craigyjp/PolyKit-DUO-polyphonic-synthesizer/block_diagram.jpg

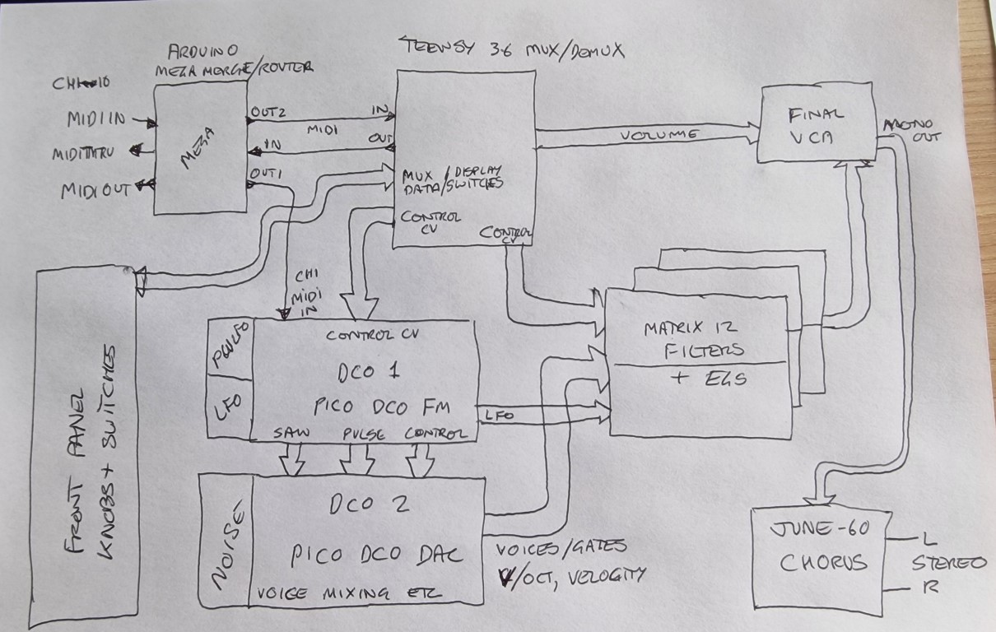
block_diagram.jpg
