craigyjp/PolyKit-DUO-polyphonic-synthesizer/photos/20220804_140941 (Medium).jpg

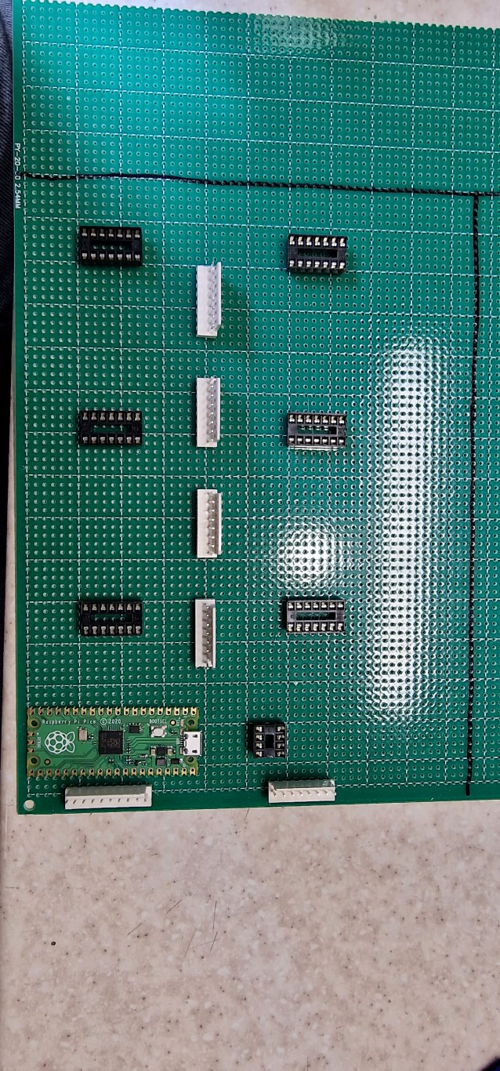
photos/20220804_140941 (Medium).jpg
