craigyjp/PolyKit-DUO-polyphonic-synthesizer/photos/20220806_120722 (Medium).jpg

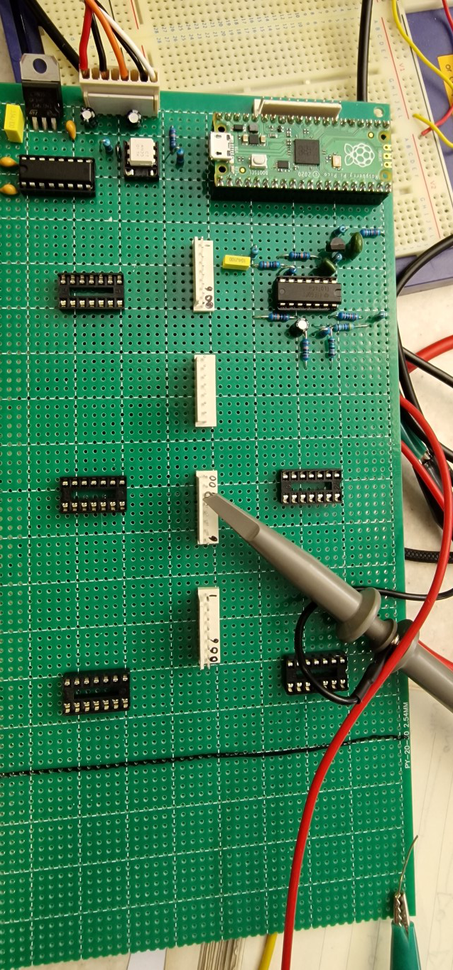
photos/20220806_120722 (Medium).jpg
