craigyjp/PolyKit-DUO-polyphonic-synthesizer/photos/20220806_134830 (Medium).jpg

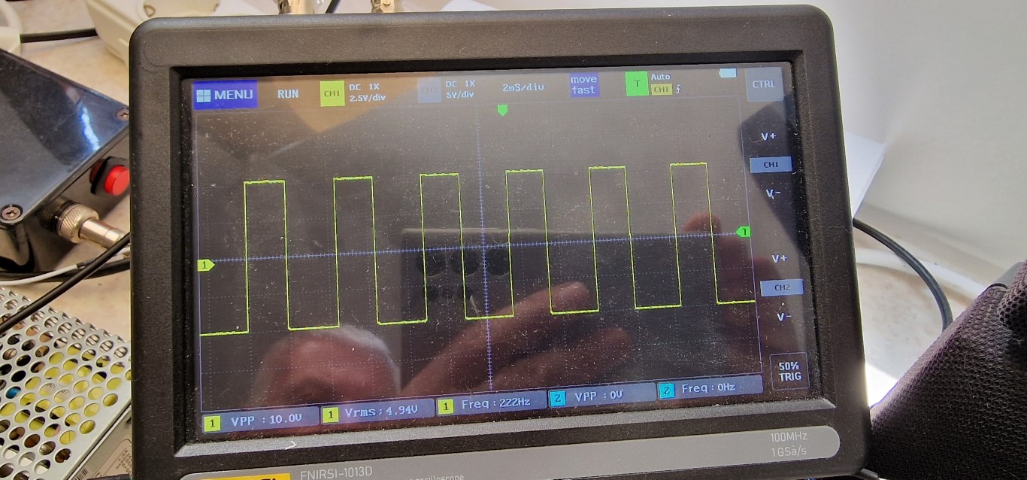
photos/20220806_134830 (Medium).jpg
