craigyjp/PolyKit-DUO-polyphonic-synthesizer/photos/20220806_134958 (Medium).jpg

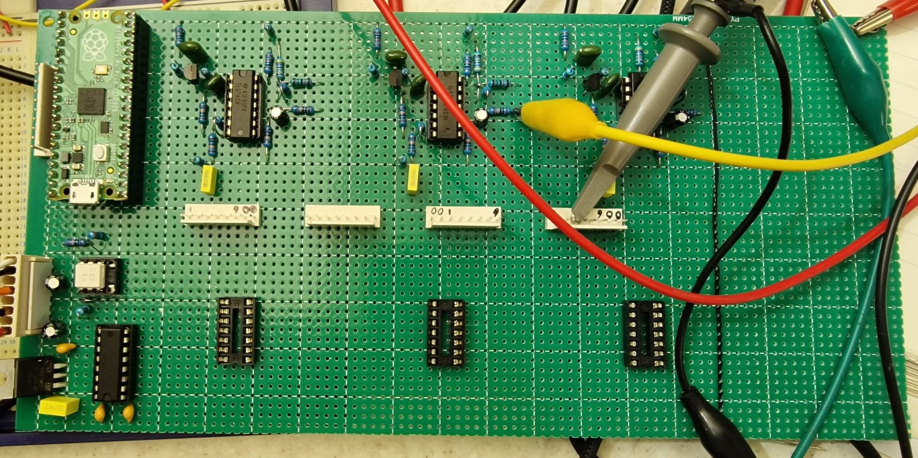
photos/20220806_134958 (Medium).jpg
