craigyjp/PolyKit-DUO-polyphonic-synthesizer/photos/20220814_142116 (Medium).jpg

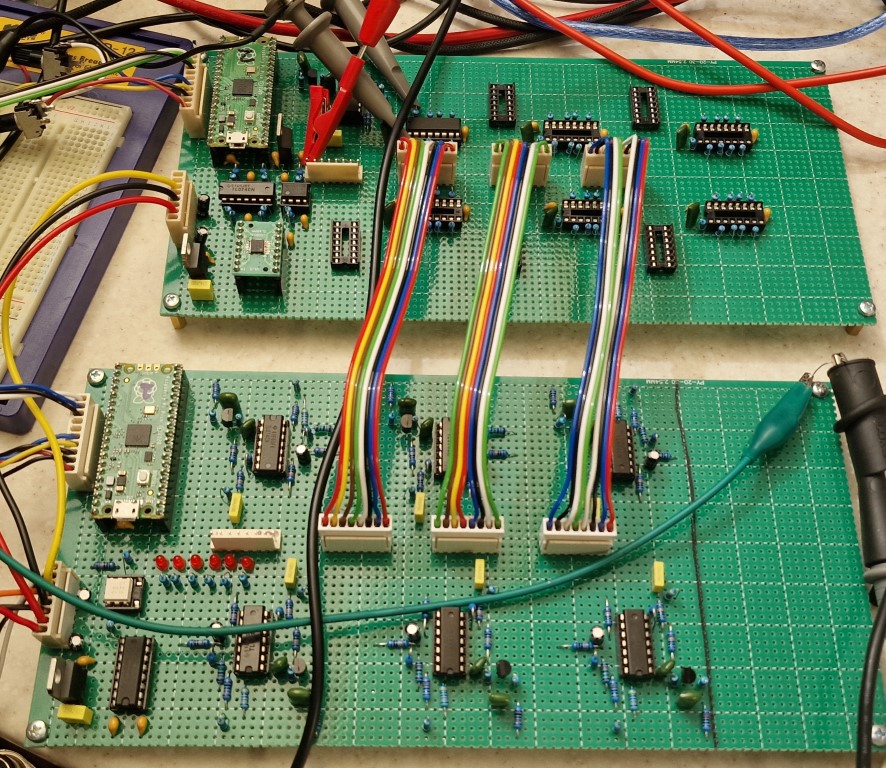
photos/20220814_142116 (Medium).jpg
