craigyjp/PolyKit-DUO-polyphonic-synthesizer/photos/20220903_174634 (Medium).jpg

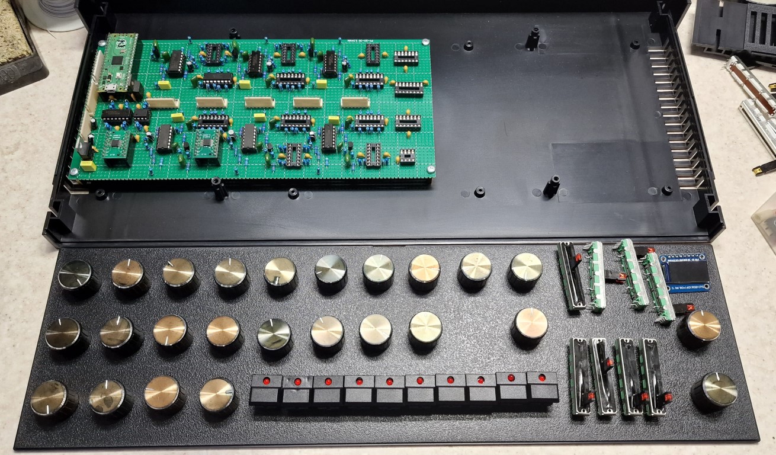
photos/20220903_174634 (Medium).jpg
