craigyjp/PolyKit-DUO-polyphonic-synthesizer/photos/20220903_183336 (Medium).jpg

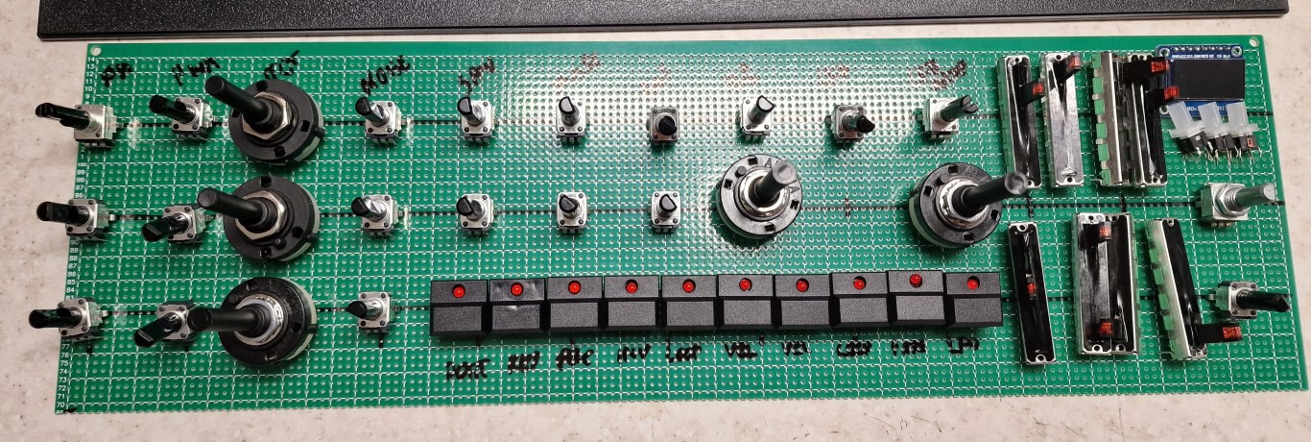
photos/20220903_183336 (Medium).jpg
