craigyjp/PolyKit-DUO-polyphonic-synthesizer/photos/20220903_201736 (Medium).jpg

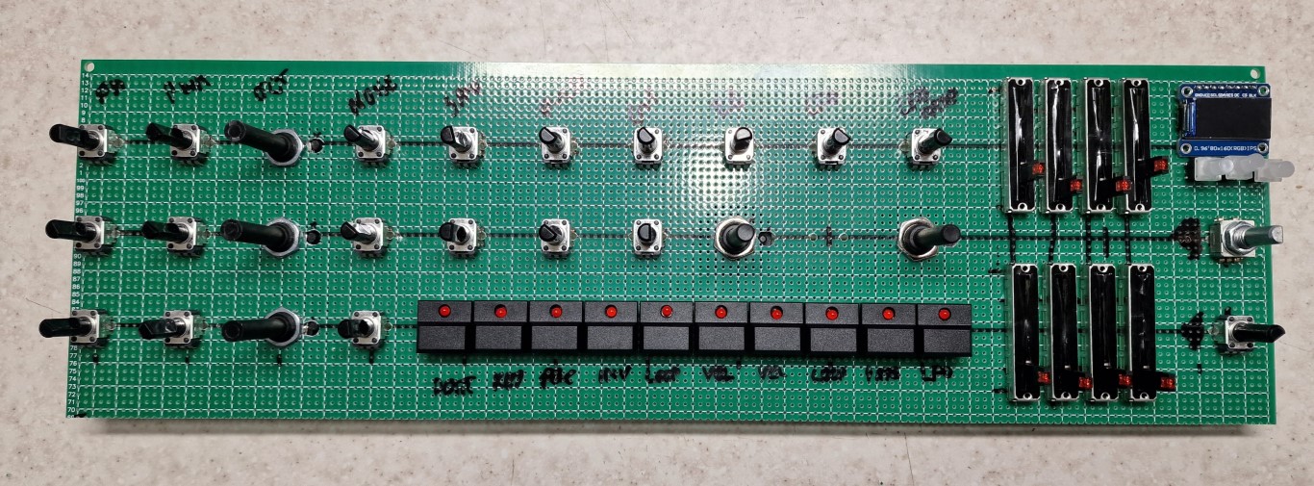
photos/20220903_201736 (Medium).jpg
