craigyjp/PolyKit-DUO-polyphonic-synthesizer/photos/20220903_202641 (Medium).jpg

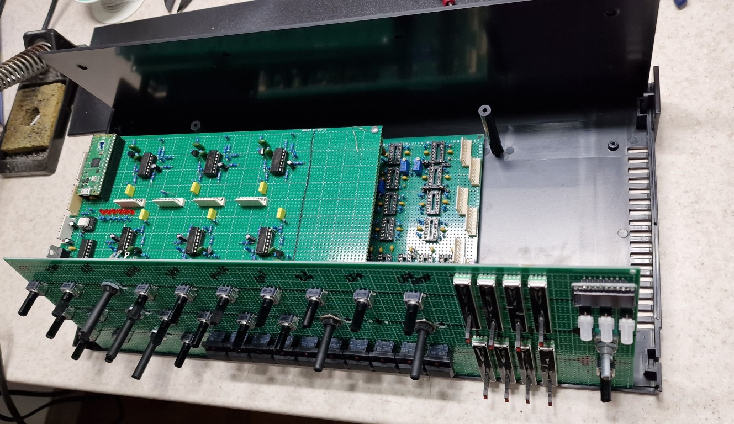
photos/20220903_202641 (Medium).jpg
