craigyjp/PolyKit-DUO-polyphonic-synthesizer/photos/20220904_141923 (Medium).jpg

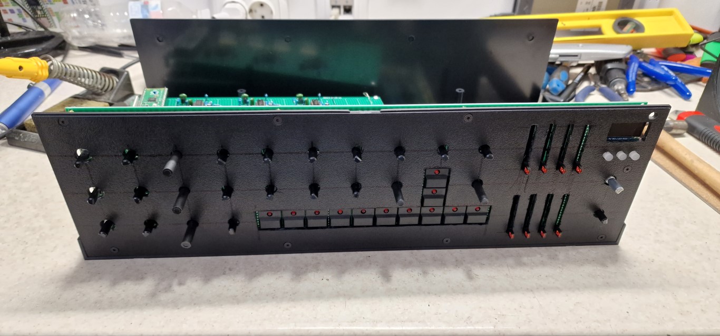
photos/20220904_141923 (Medium).jpg
