craigyjp/PolyKit-DUO-polyphonic-synthesizer/photos/20220904_142112 (Medium).jpg

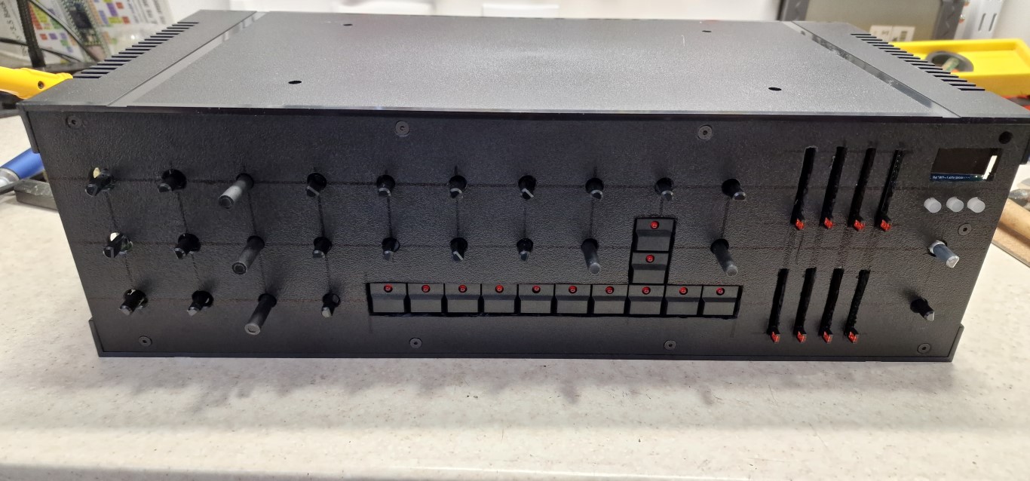
photos/20220904_142112 (Medium).jpg
