craigyjp/PolyKit-DUO-polyphonic-synthesizer/photos/20220905_204254 (Medium).jpg

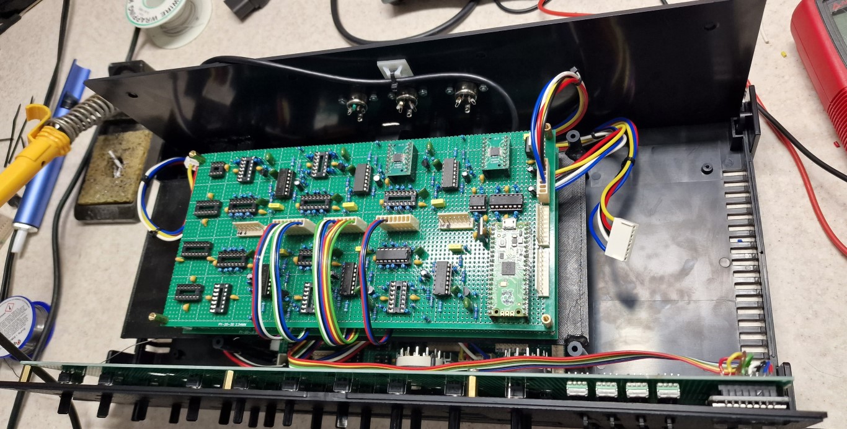
photos/20220905_204254 (Medium).jpg
