craigyjp/PolyKit-DUO-polyphonic-synthesizer/photos/20220906_171613 (Medium).jpg

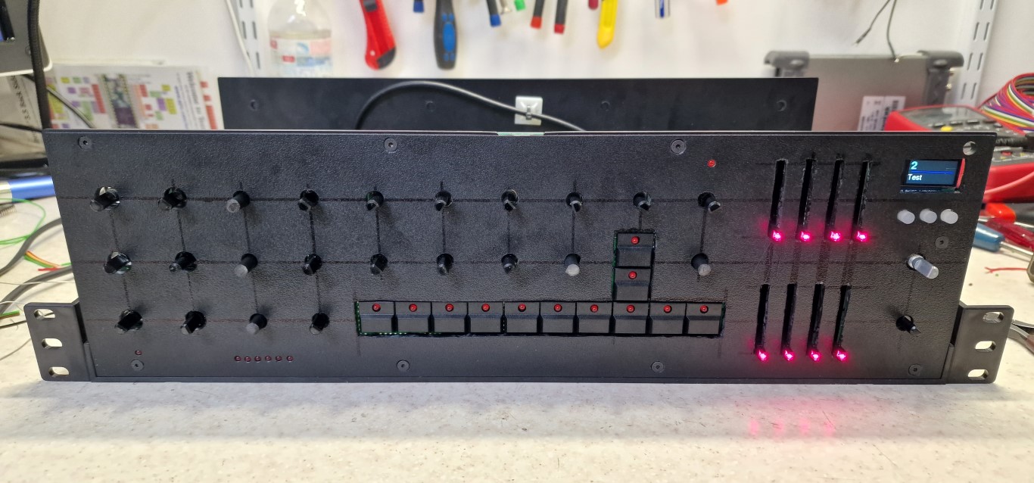
photos/20220906_171613 (Medium).jpg
