craigyjp/PolyKit-DUO-polyphonic-synthesizer/photos/20220906_172613 (Medium).jpg

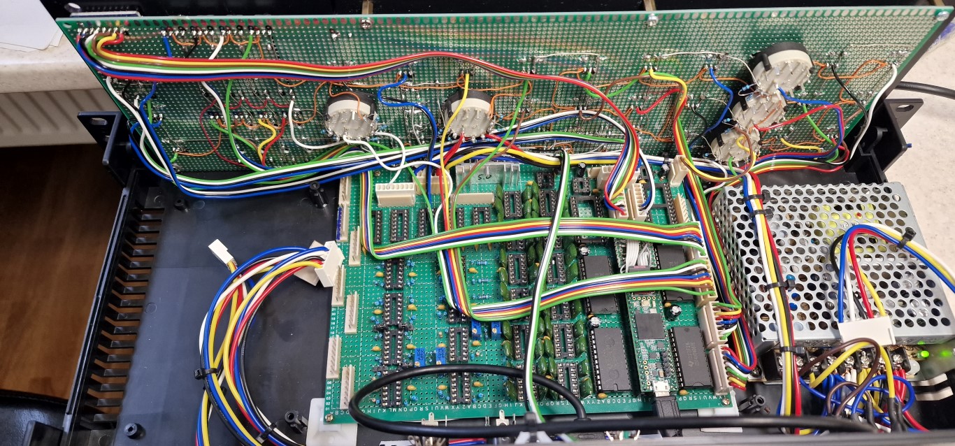
photos/20220906_172613 (Medium).jpg
