craigyjp/PolyKit-DUO-polyphonic-synthesizer/photos/20220908_191327 (Medium).jpg

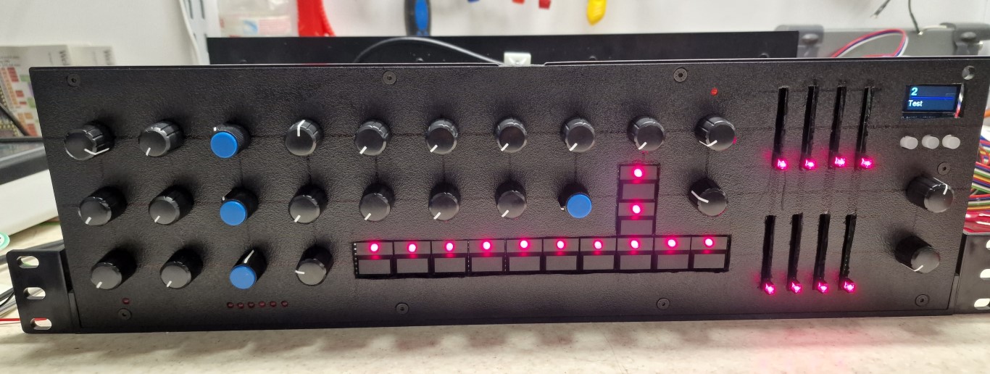
photos/20220908_191327 (Medium).jpg
