craigyjp/PolyKit-DUO-polyphonic-synthesizer/photos/20220908_191333 (Medium).jpg

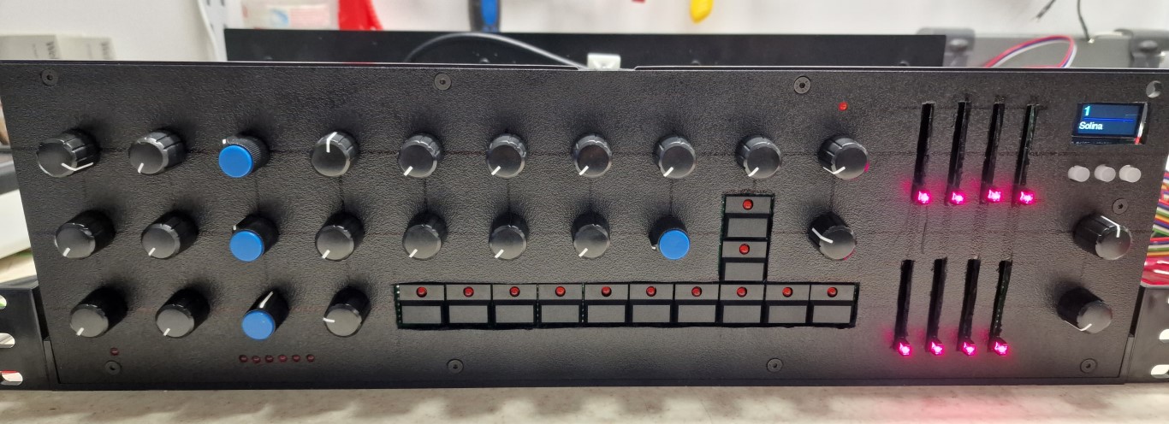
photos/20220908_191333 (Medium).jpg
