craigyjp/PolyKit-DUO-polyphonic-synthesizer/photos/20220909_180552 (Medium).jpg

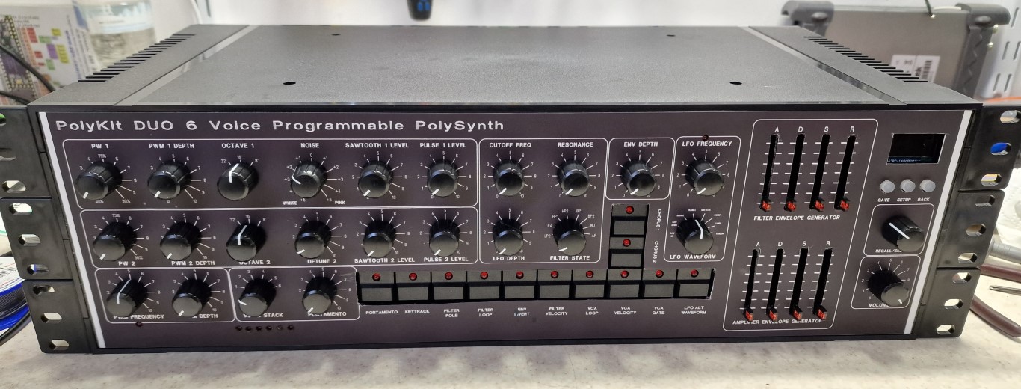
photos/20220909_180552 (Medium).jpg
