craigyjp/PolyKit-DUO-polyphonic-synthesizer/photos/20220909_211127 (Medium).jpg

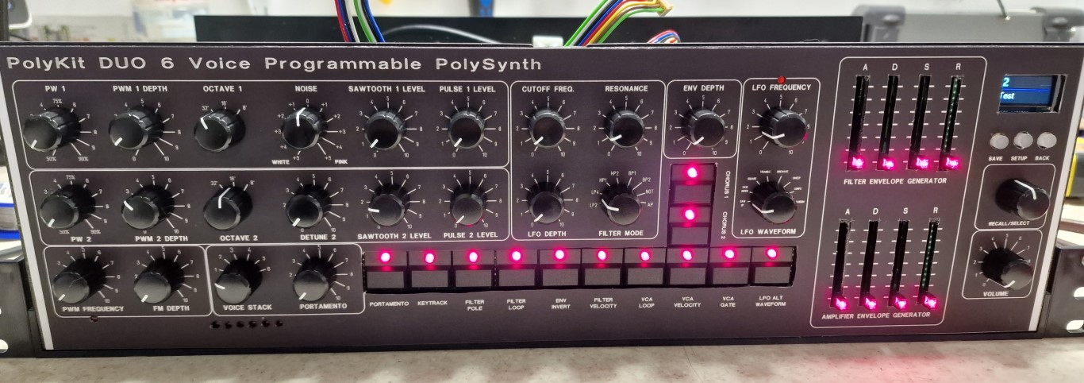
photos/20220909_211127 (Medium).jpg
