craigyjp/PolyKit-DUO-polyphonic-synthesizer/photos/20220912_173930 (Medium).jpg

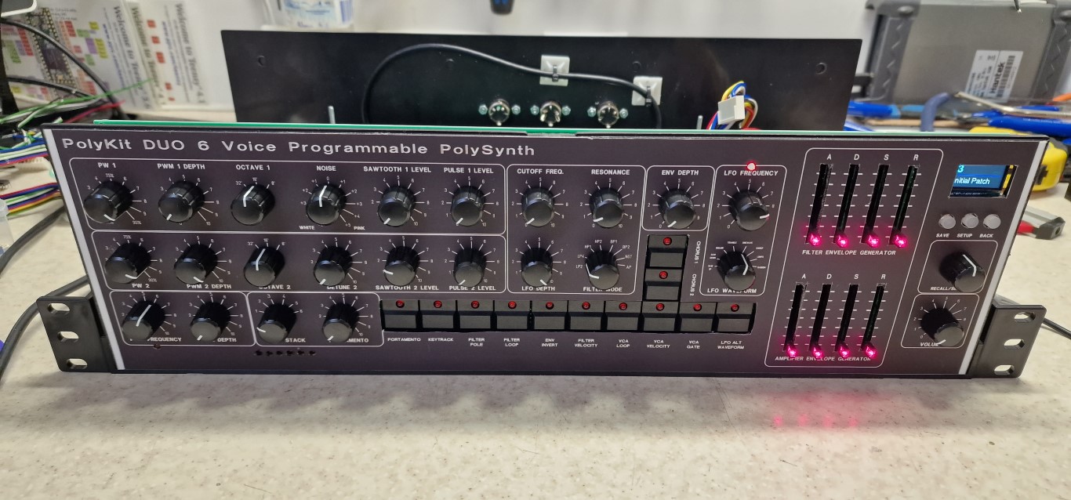
photos/20220912_173930 (Medium).jpg
