craigyjp/PolyKit-DUO-polyphonic-synthesizer/photos/20220913_212919 (Medium).jpg

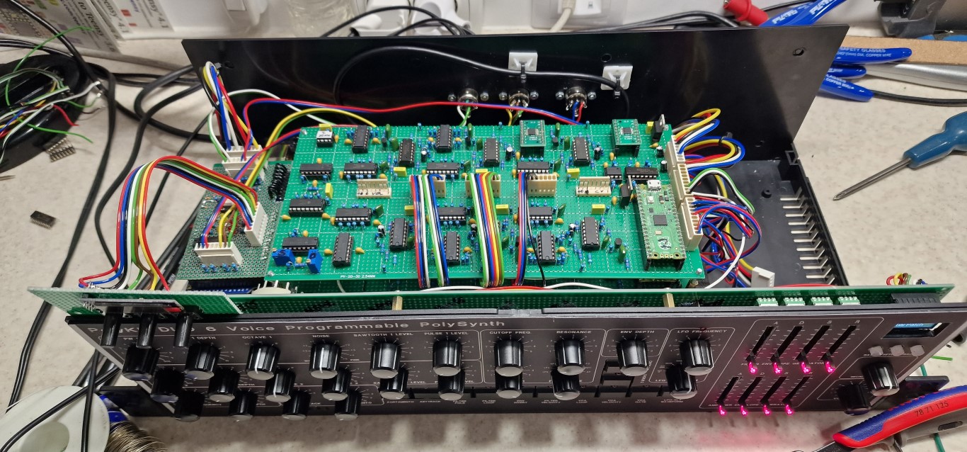
photos/20220913_212919 (Medium).jpg
