craigyjp/PolyKit-DUO-polyphonic-synthesizer/photos/20220913_213019 (Medium).jpg

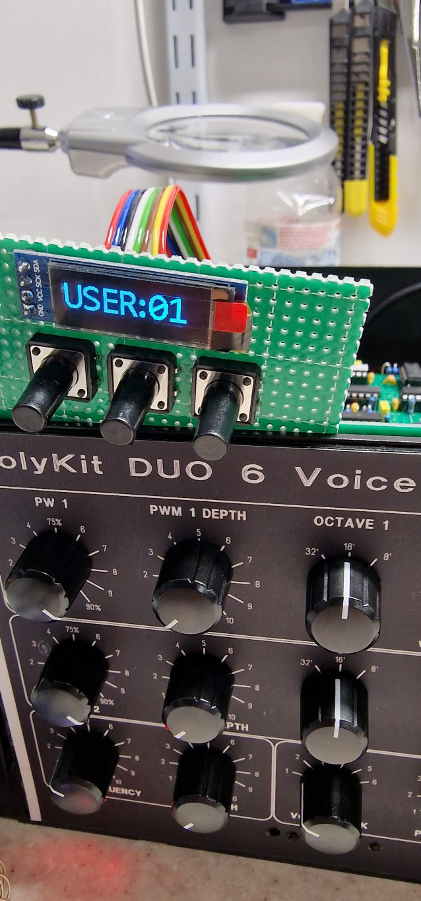
photos/20220913_213019 (Medium).jpg
