craigyjp/PolyKit-DUO-polyphonic-synthesizer/photos/20220914_204759 (Medium).jpg

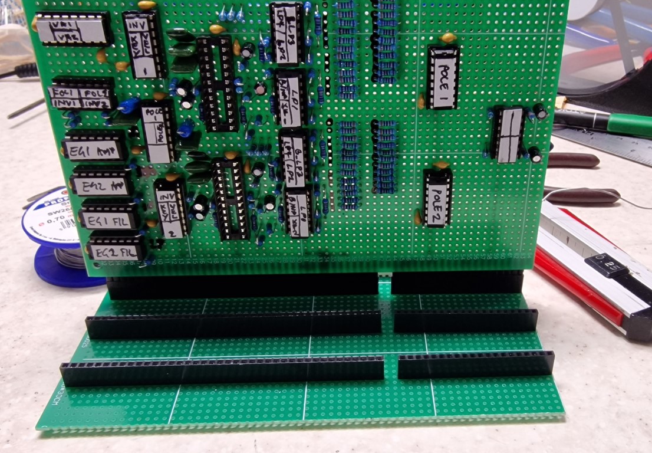
photos/20220914_204759 (Medium).jpg
