craigyjp/PolyKit-DUO-polyphonic-synthesizer/photos/20220914_204813 (Medium).jpg

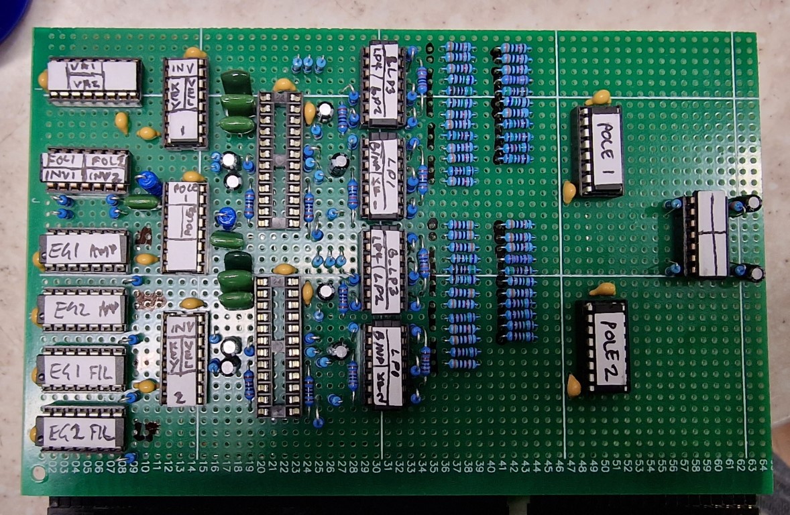
photos/20220914_204813 (Medium).jpg
