craigyjp/PolyKit-DUO-polyphonic-synthesizer/photos/20220915_210134 (Medium).jpg

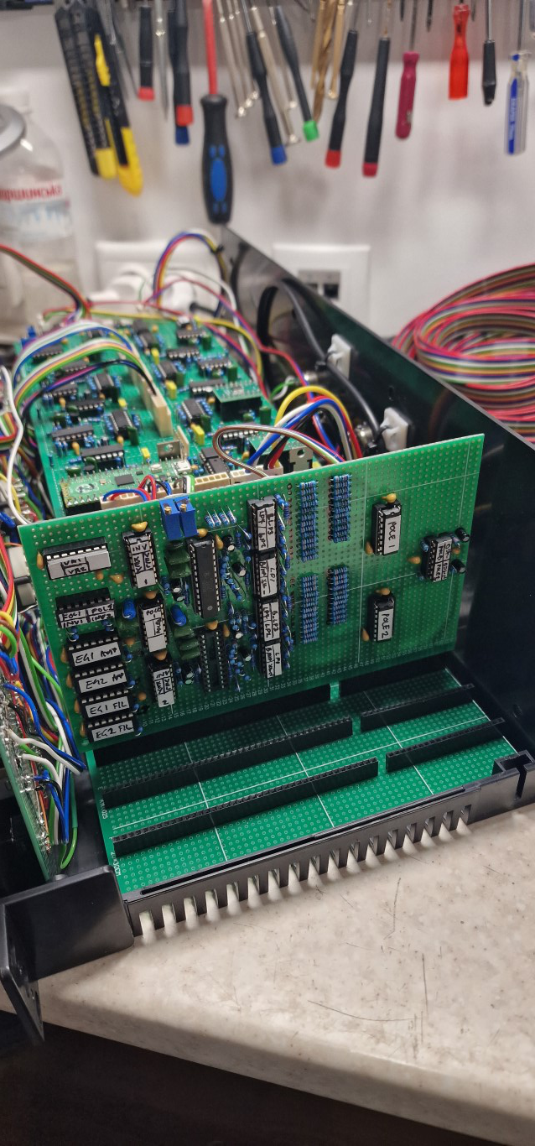
photos/20220915_210134 (Medium).jpg
