craigyjp/PolyKit-DUO-polyphonic-synthesizer/photos/20220918_163507 (Medium).jpg

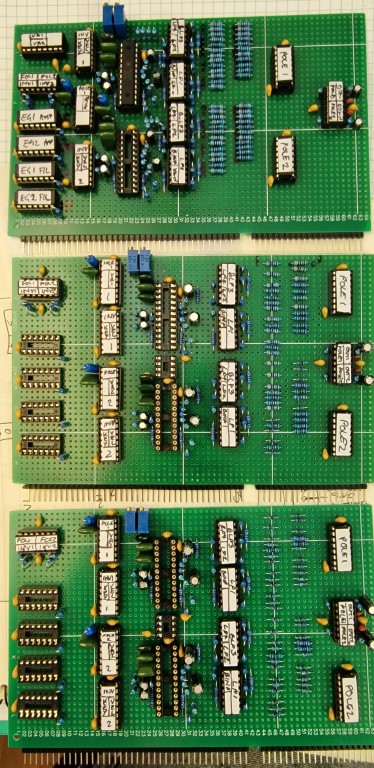
photos/20220918_163507 (Medium).jpg
