craigyjp/PolyKit-DUO-polyphonic-synthesizer/photos/20220919_204006 (Medium).jpg

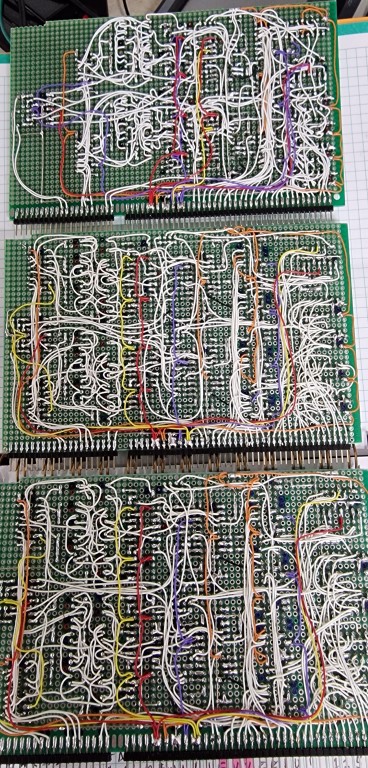
photos/20220919_204006 (Medium).jpg
