craigyjp/PolyKit-DUO-polyphonic-synthesizer/photos/20220921_220232 (Medium).jpg

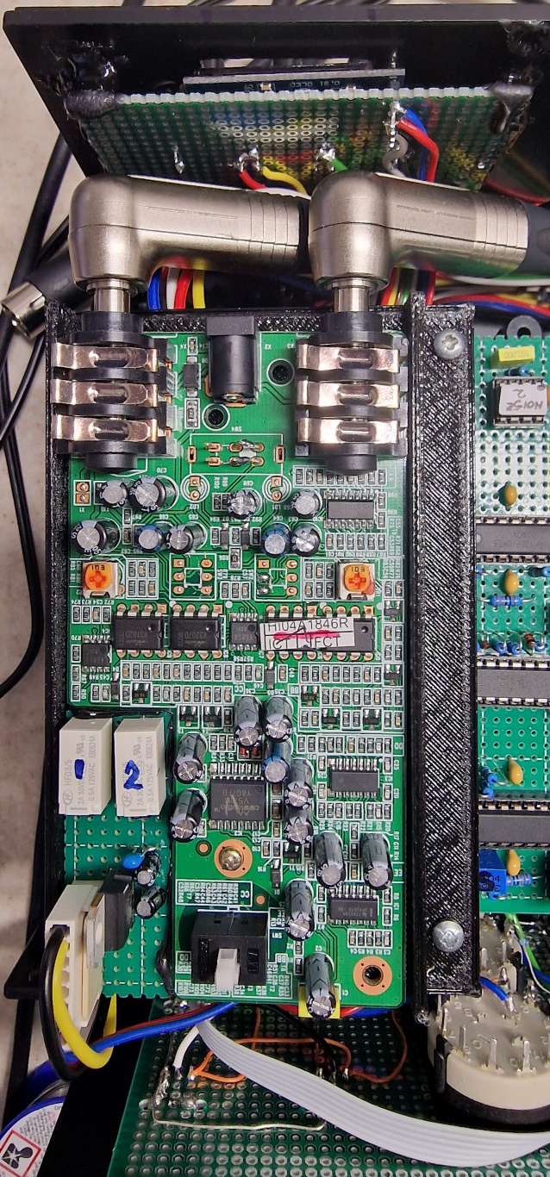
photos/20220921_220232 (Medium).jpg
