craigyjp/PolyKit-DUO-polyphonic-synthesizer/photos/FB_IMG_1662670874950 (Medium).jpg

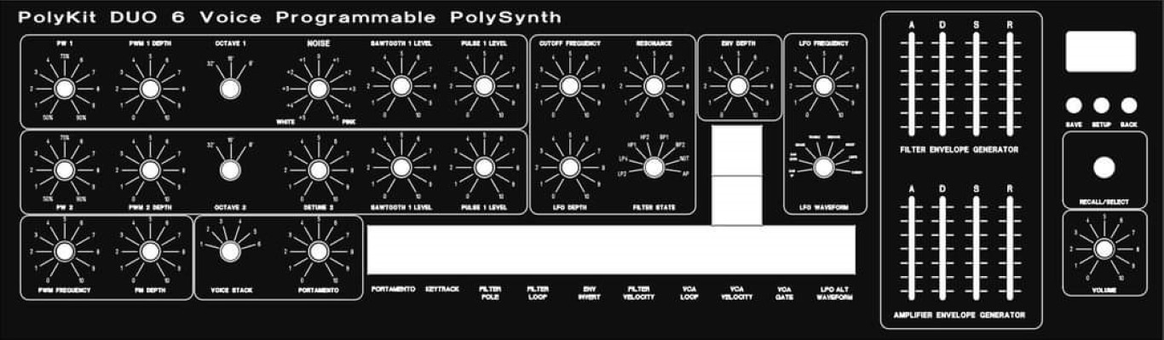
photos/FB_IMG_1662670874950 (Medium).jpg
