craigyjp/PolyKit-DUO-polyphonic-synthesizer/photos/received_1017338315625798 (Medium).jpg

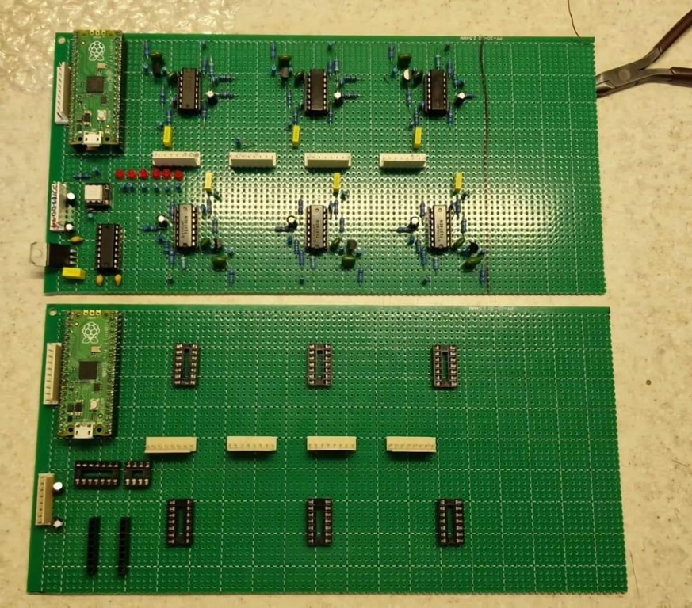
photos/received_1017338315625798 (Medium).jpg
