craigyjp/PolyKit-DUO-polyphonic-synthesizer/schematics/Schematic_Noise Fader_2022-01-20.pdf

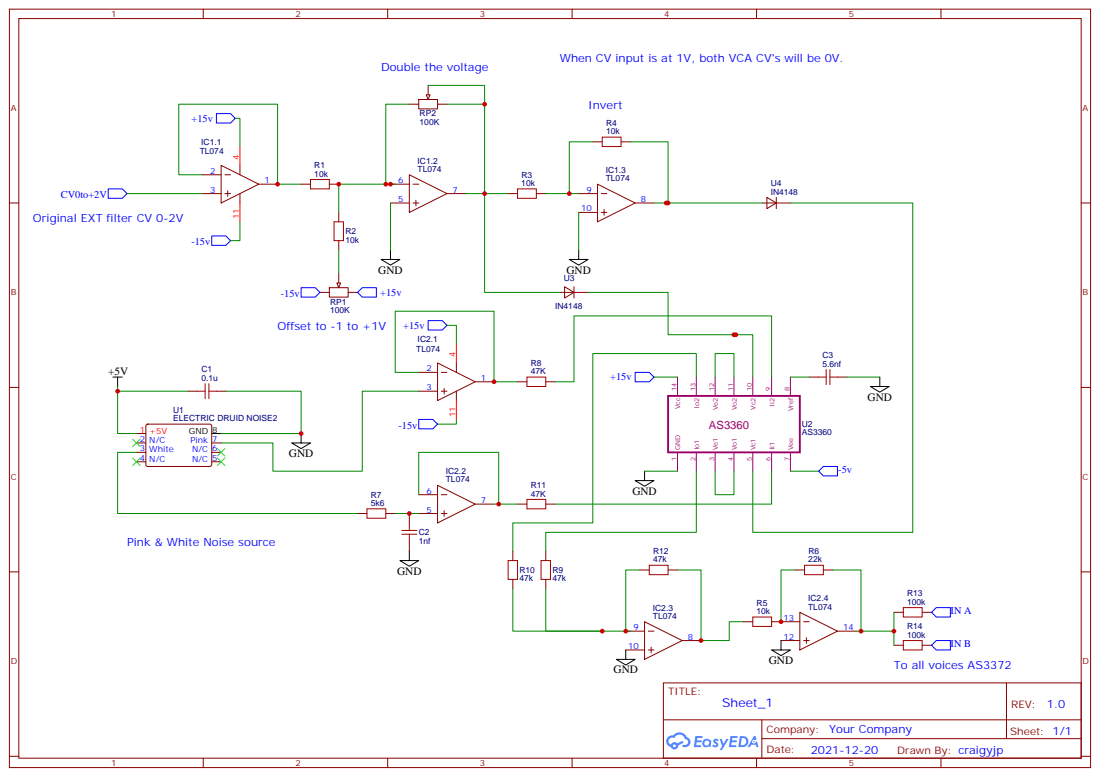
[picture p35: page 1]

When CV input is at 1V, both VCA CV's will be 0V.

Original EXT filter CV 0-2V

Pink & White Noise source
