craigyjp/PolyKit-DUO-polyphonic-synthesizer/schematics/programmer1.pdf

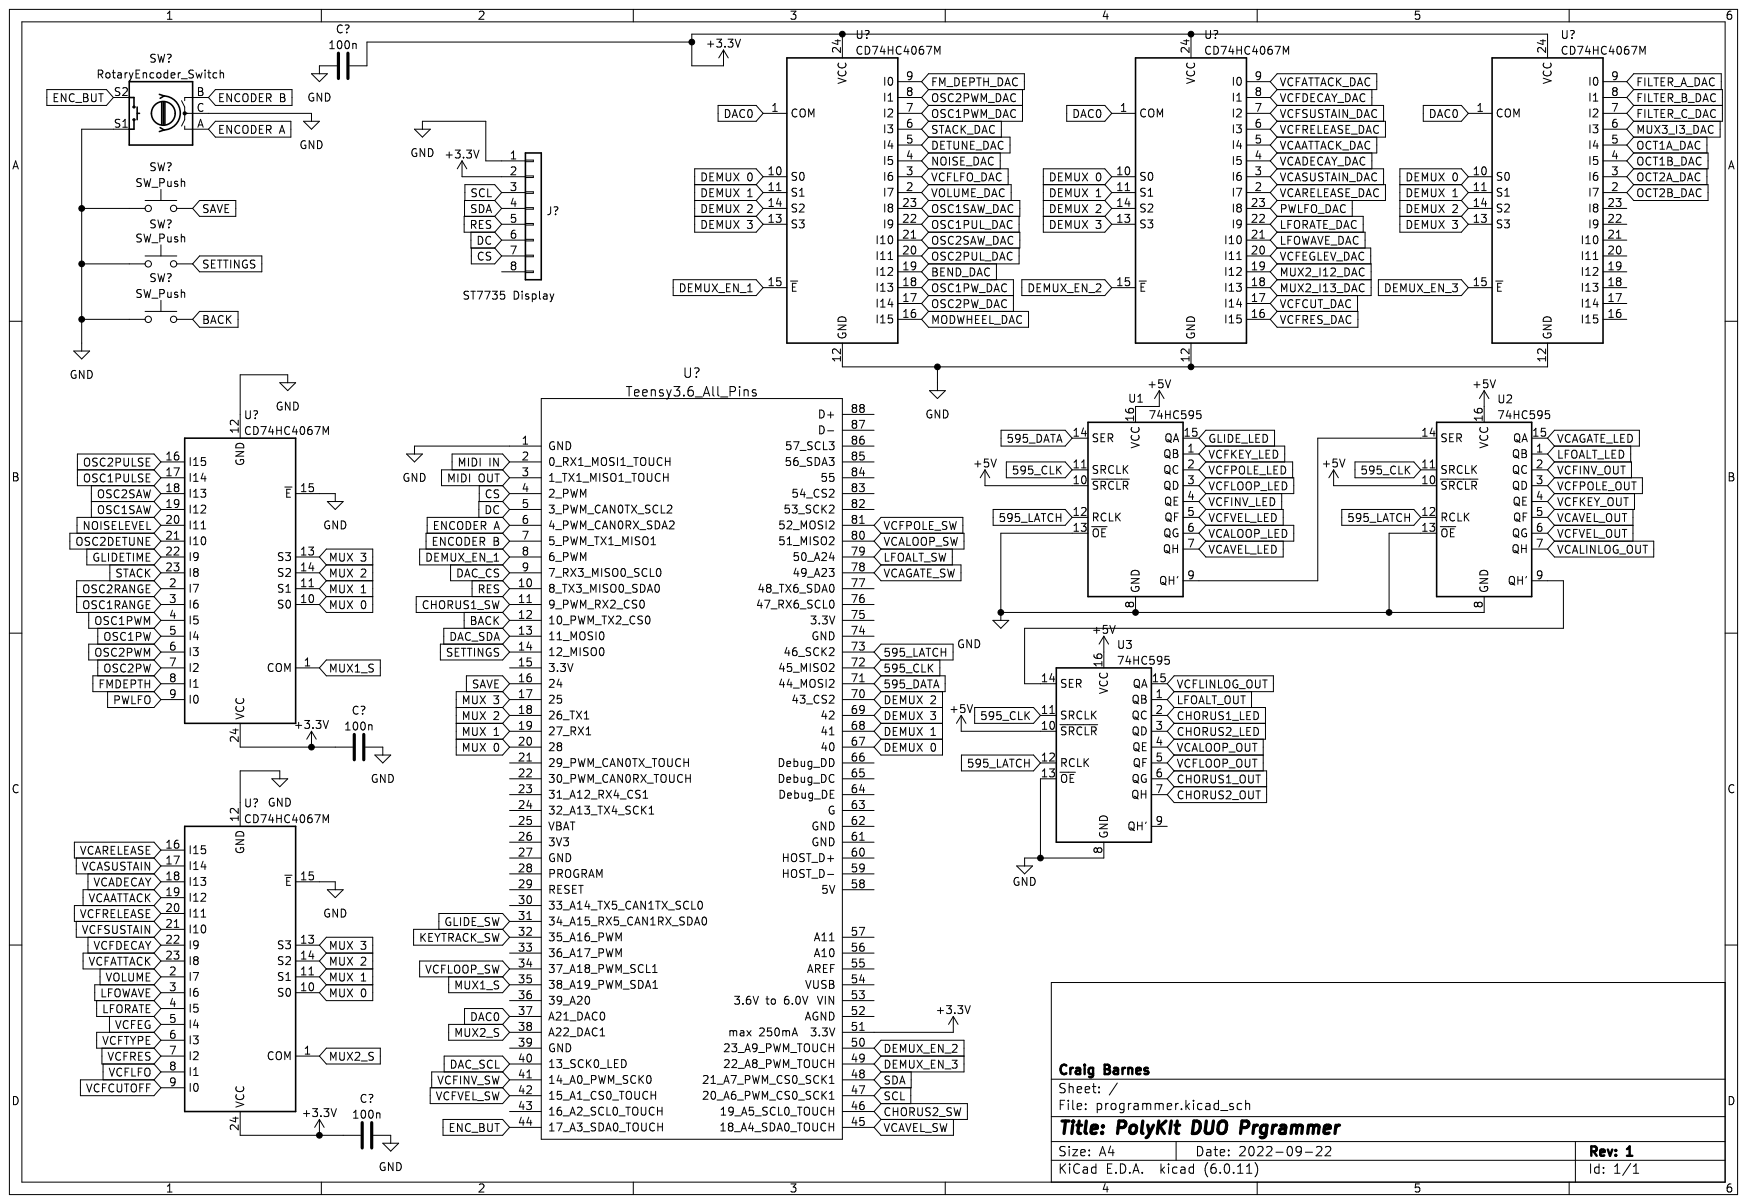
[picture p36: page 1]
