craigyjp/PolyKit-DUO-polyphonic-synthesizer/schematics/DCO-analogue.pdf

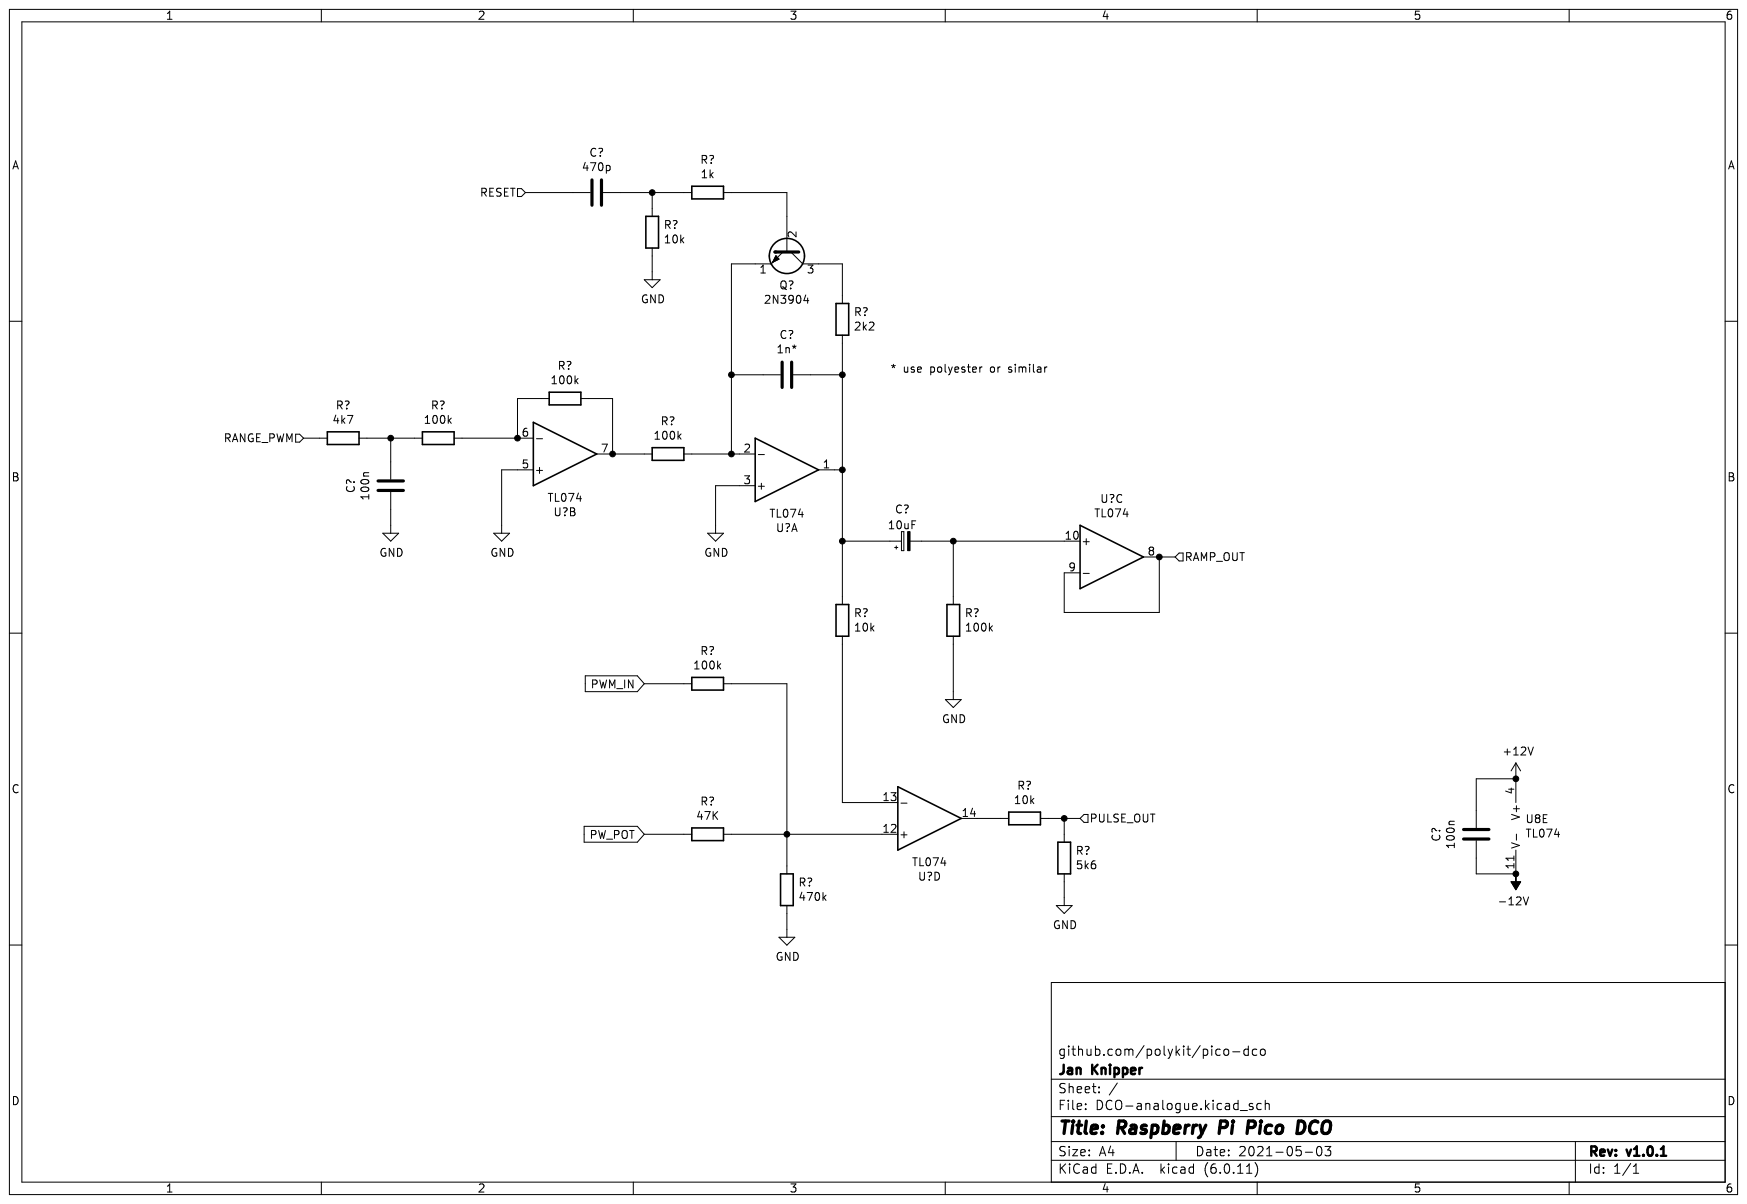
[picture p37: page 1]
