craigyjp/PolyKit-DUO-polyphonic-synthesizer/schematics/pico-dco-fm.pdf

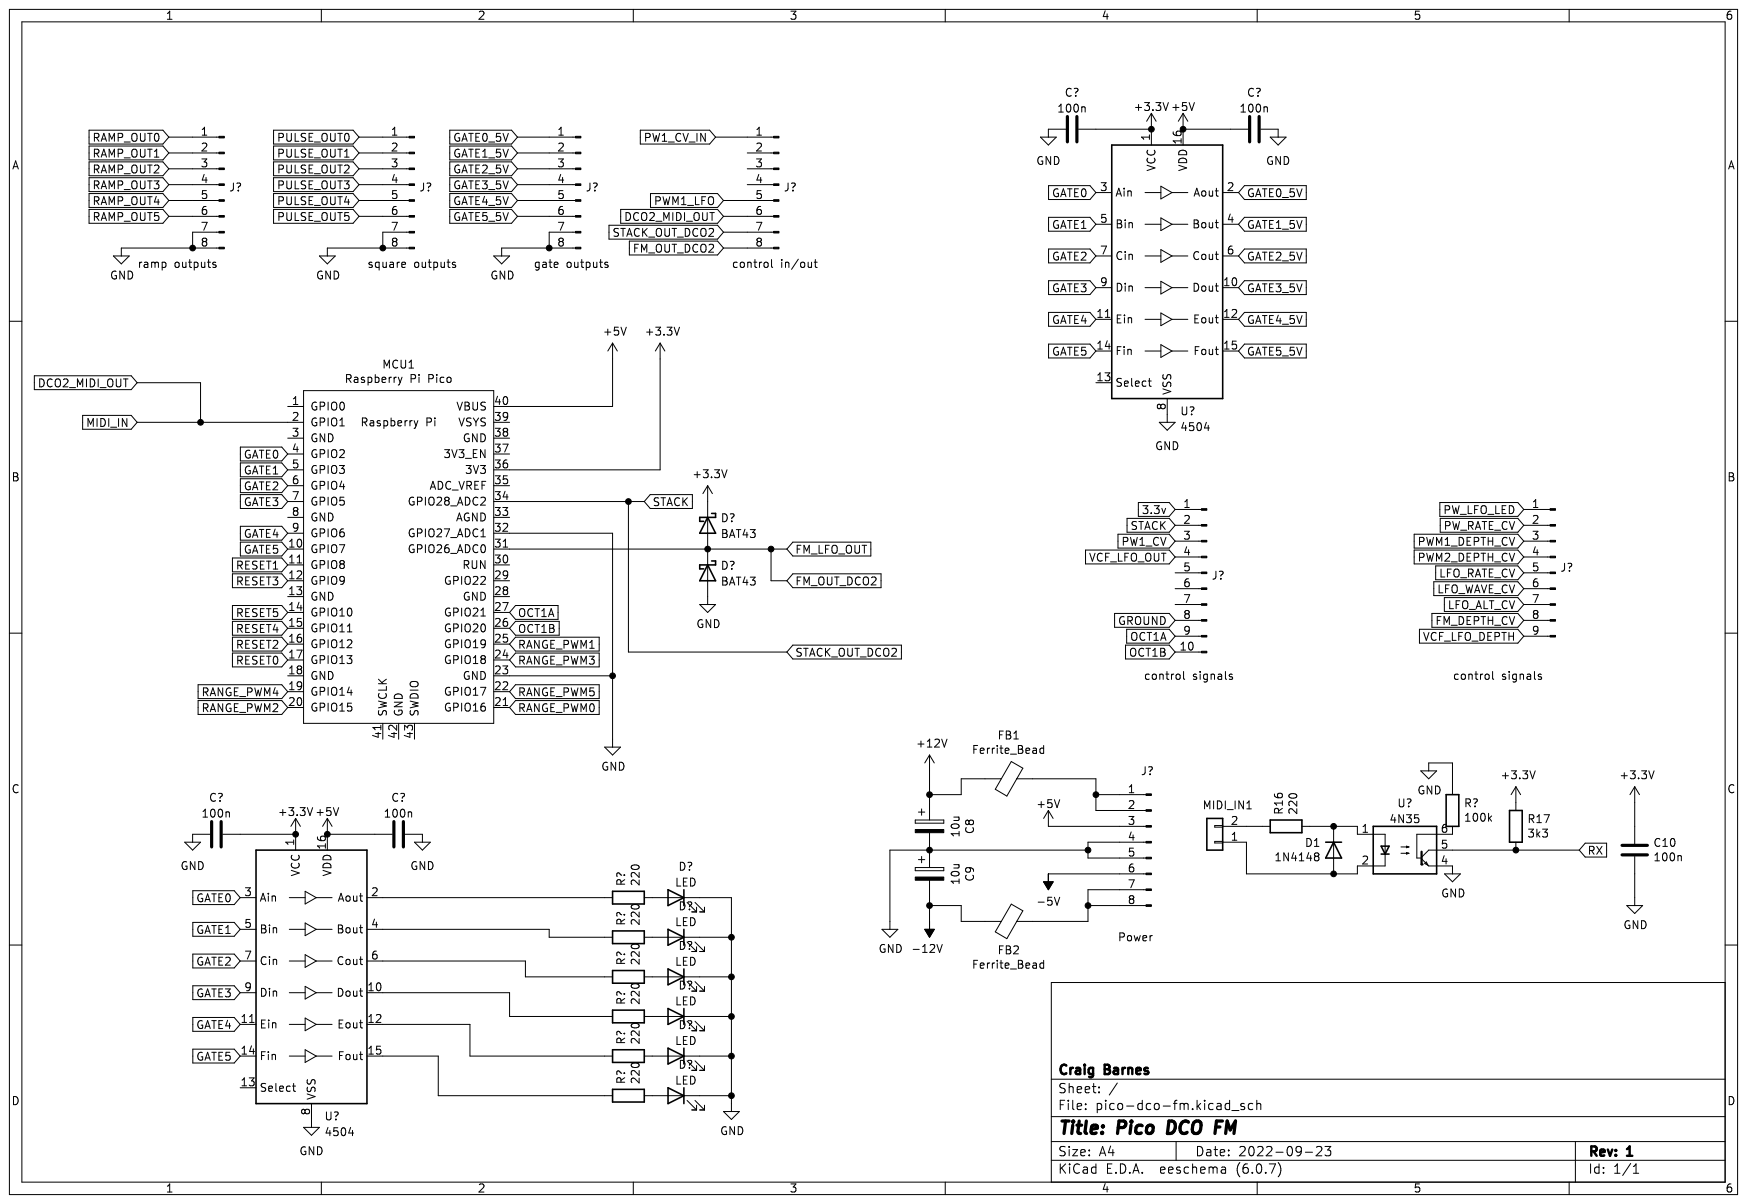
[picture p38: page 1]
