craigyjp/PolyKit-DUO-polyphonic-synthesizer/schematics/pico-dco-dac.pdf

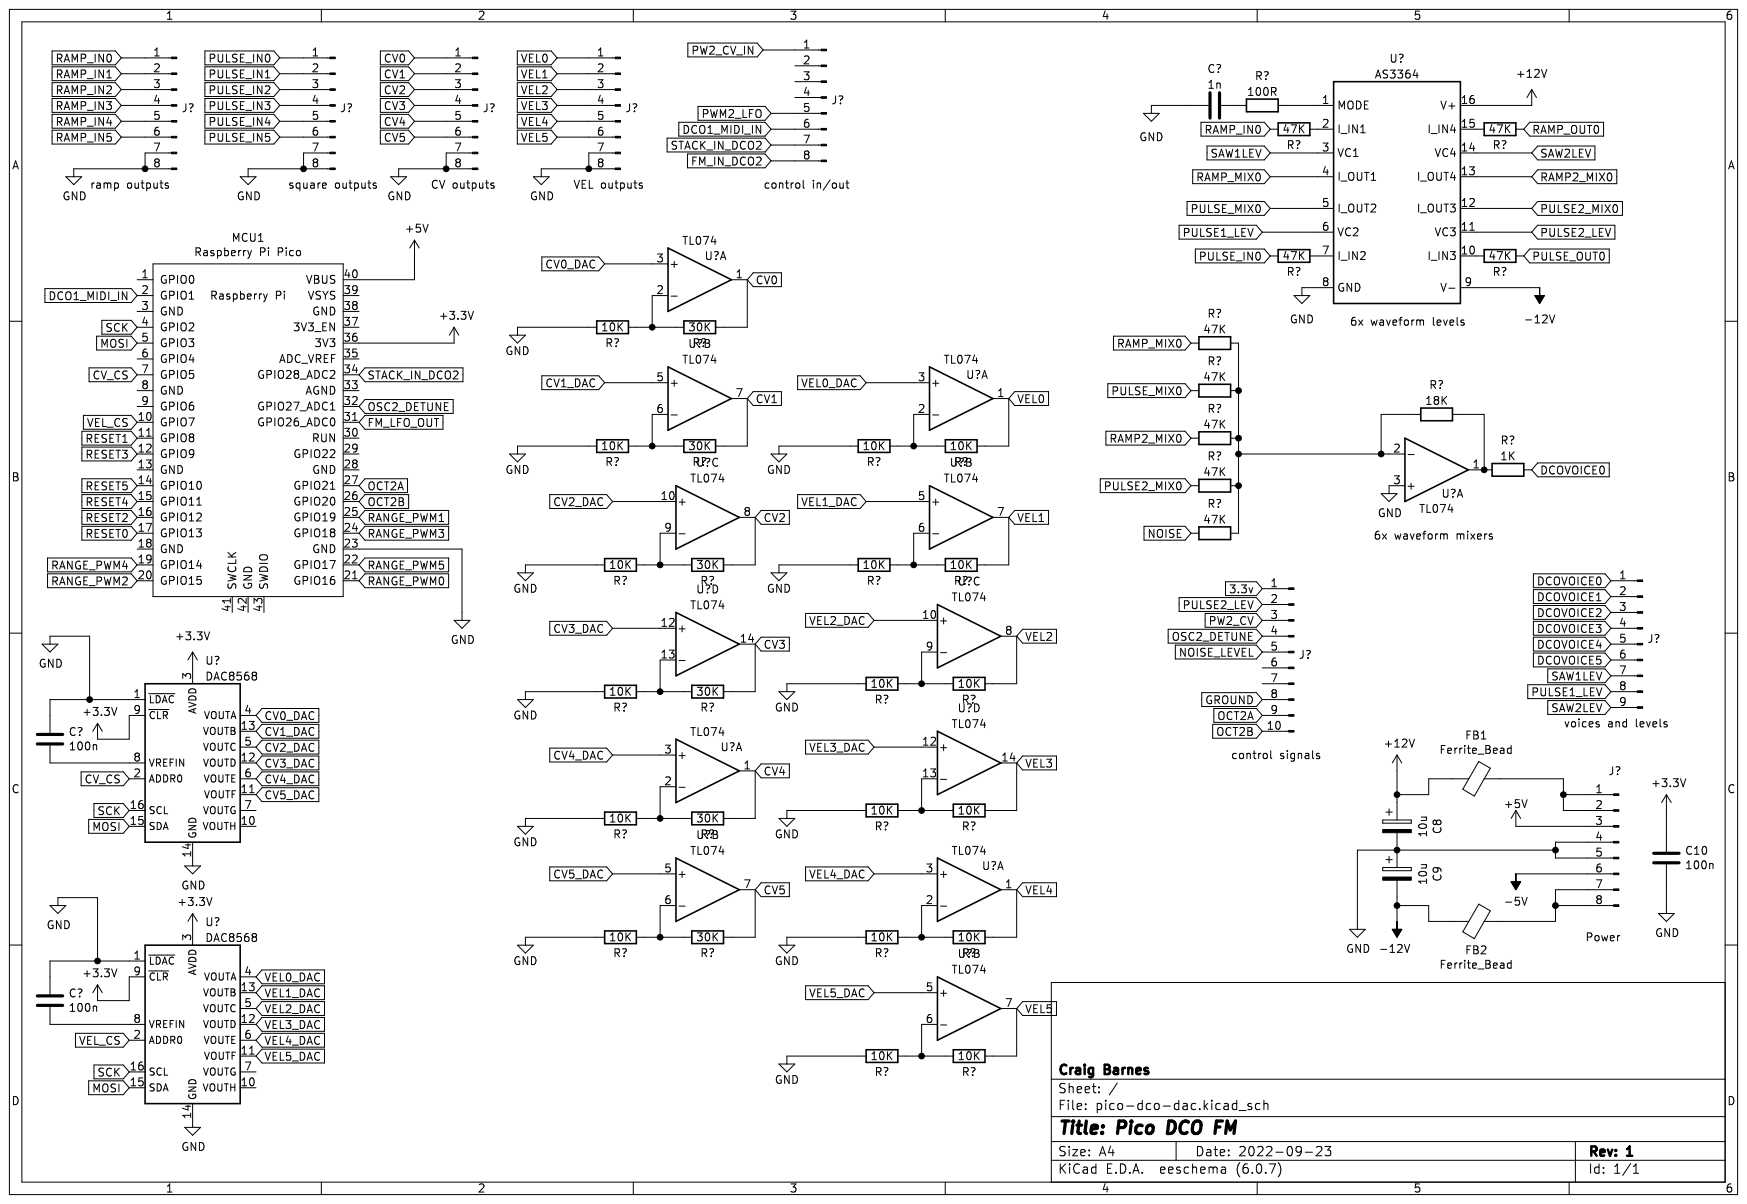
[picture p39: page 1]
