craigyjp/PolyKit-DUO-polyphonic-synthesizer/schematics/filter-control.pdf

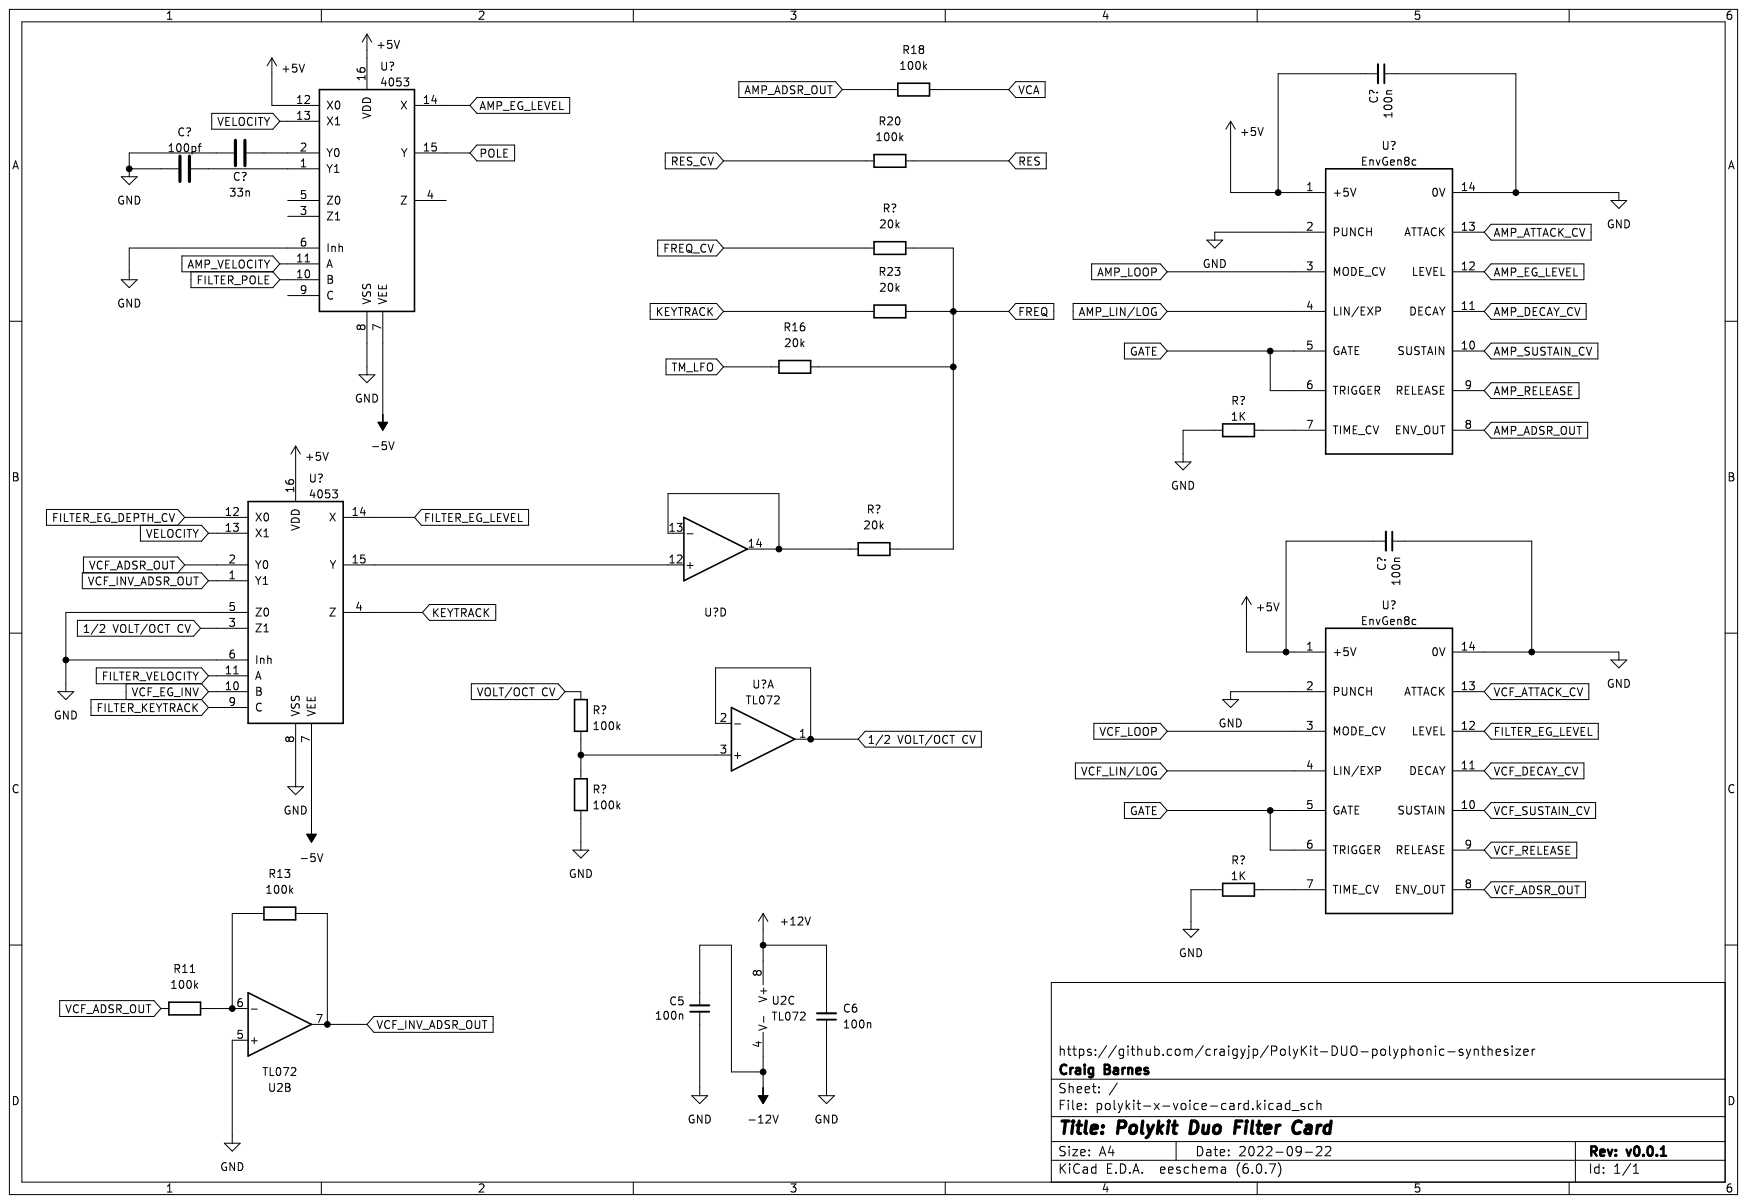
[picture p40: page 1]
