craigyjp/PolyKit-DUO-polyphonic-synthesizer/schematics/frontpanel_pots.pdf

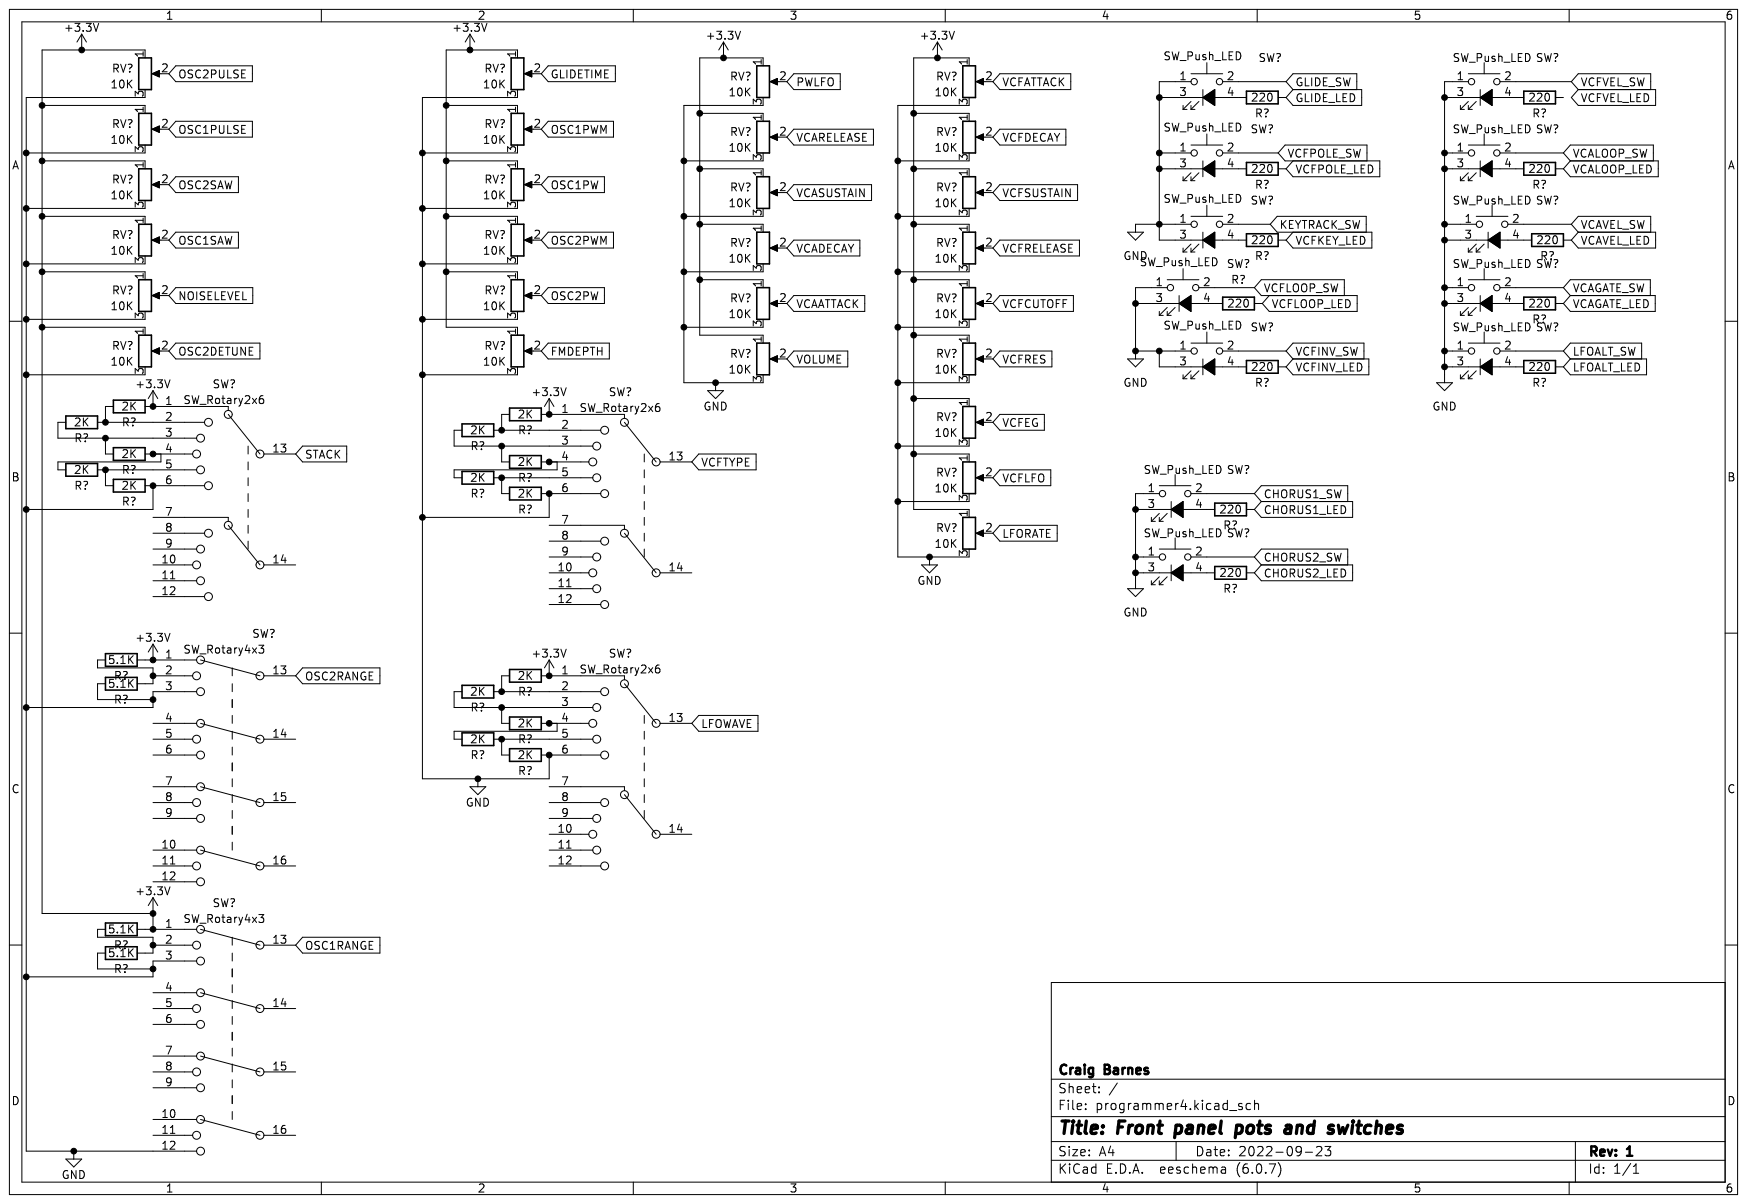
[picture p41: page 1]
