craigyjp/PolyKit-DUO-polyphonic-synthesizer/schematics/programmer2.pdf

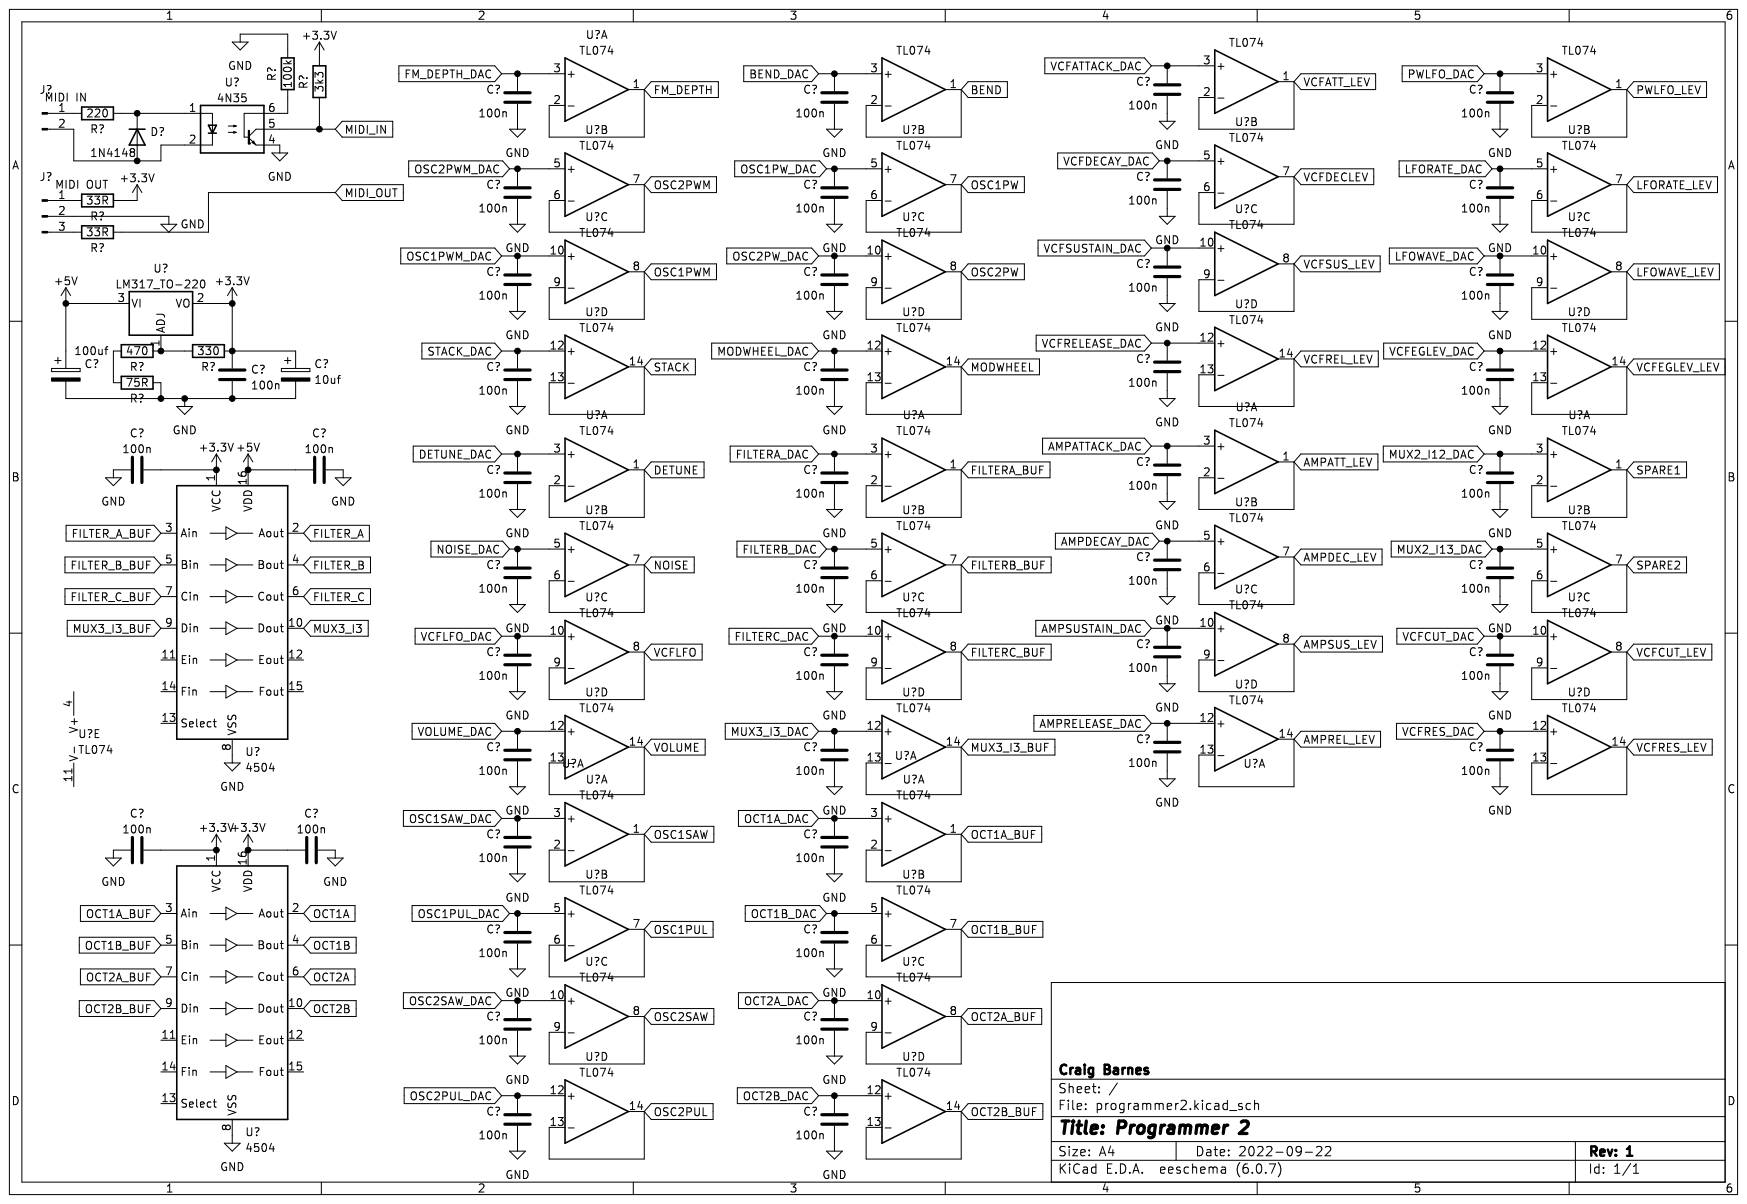
[picture p42: page 1]
