craigyjp/PolyKit-DUO-polyphonic-synthesizer/schematics/programmer3.pdf

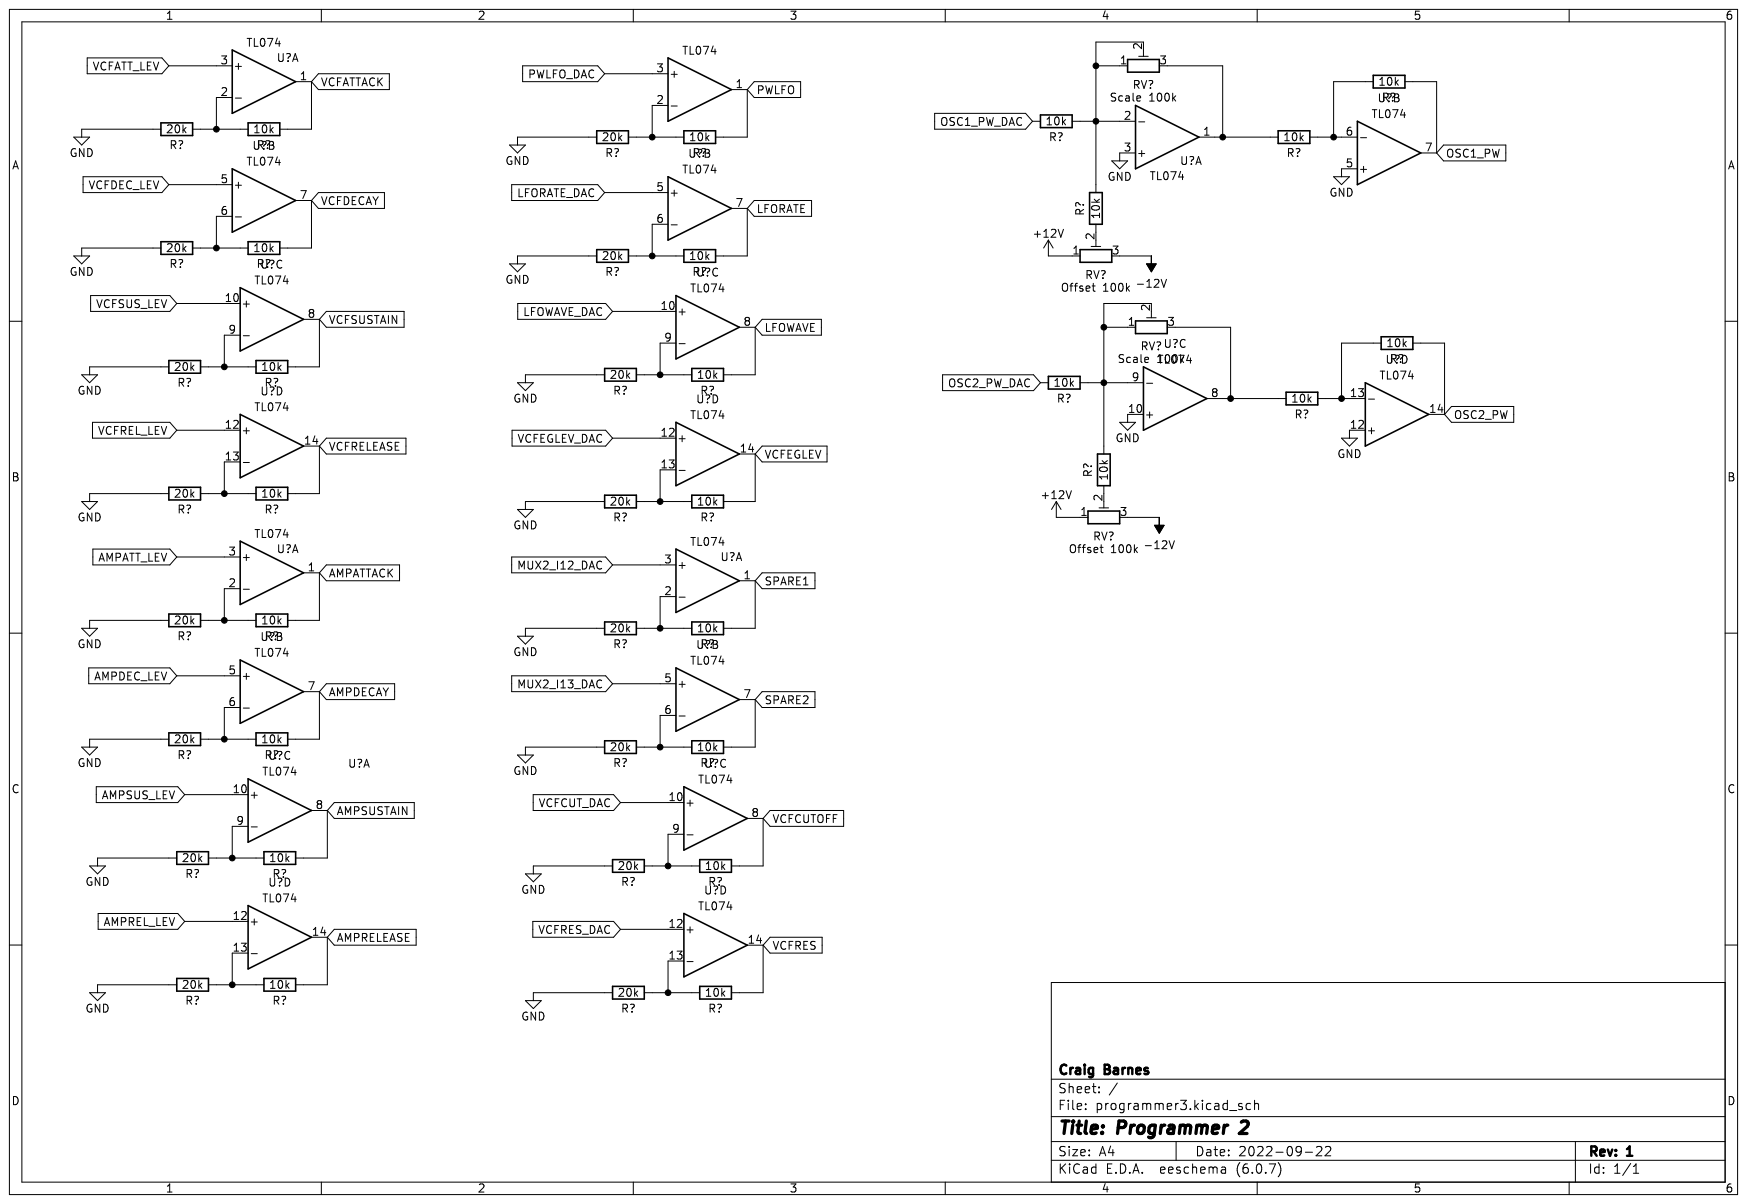
[picture p43: page 1]
