craigyjp/PolyKit-DUO-polyphonic-synthesizer/schematics/filter-AS3372.pdf

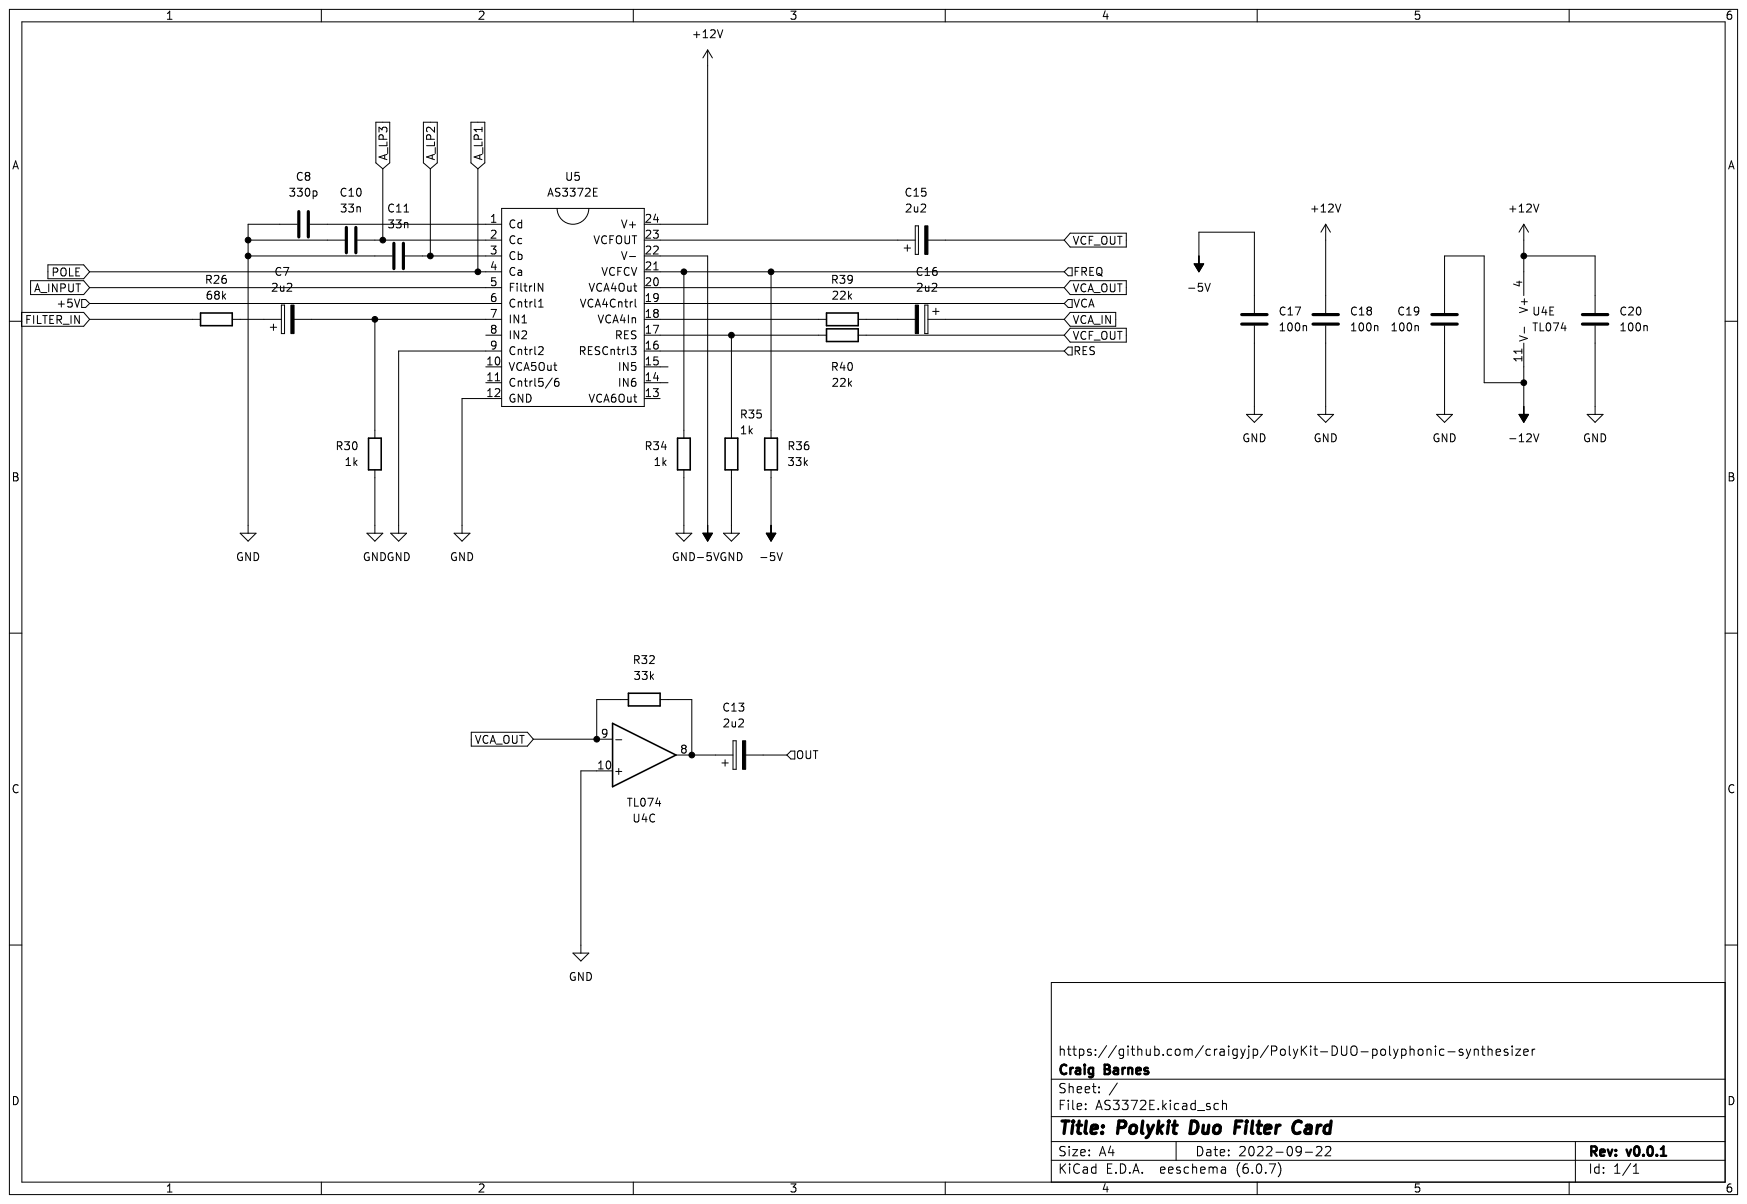
[picture p44: page 1]
