craigyjp/PolyKit-DUO-polyphonic-synthesizer/schematics/filter-pole_mixer.pdf

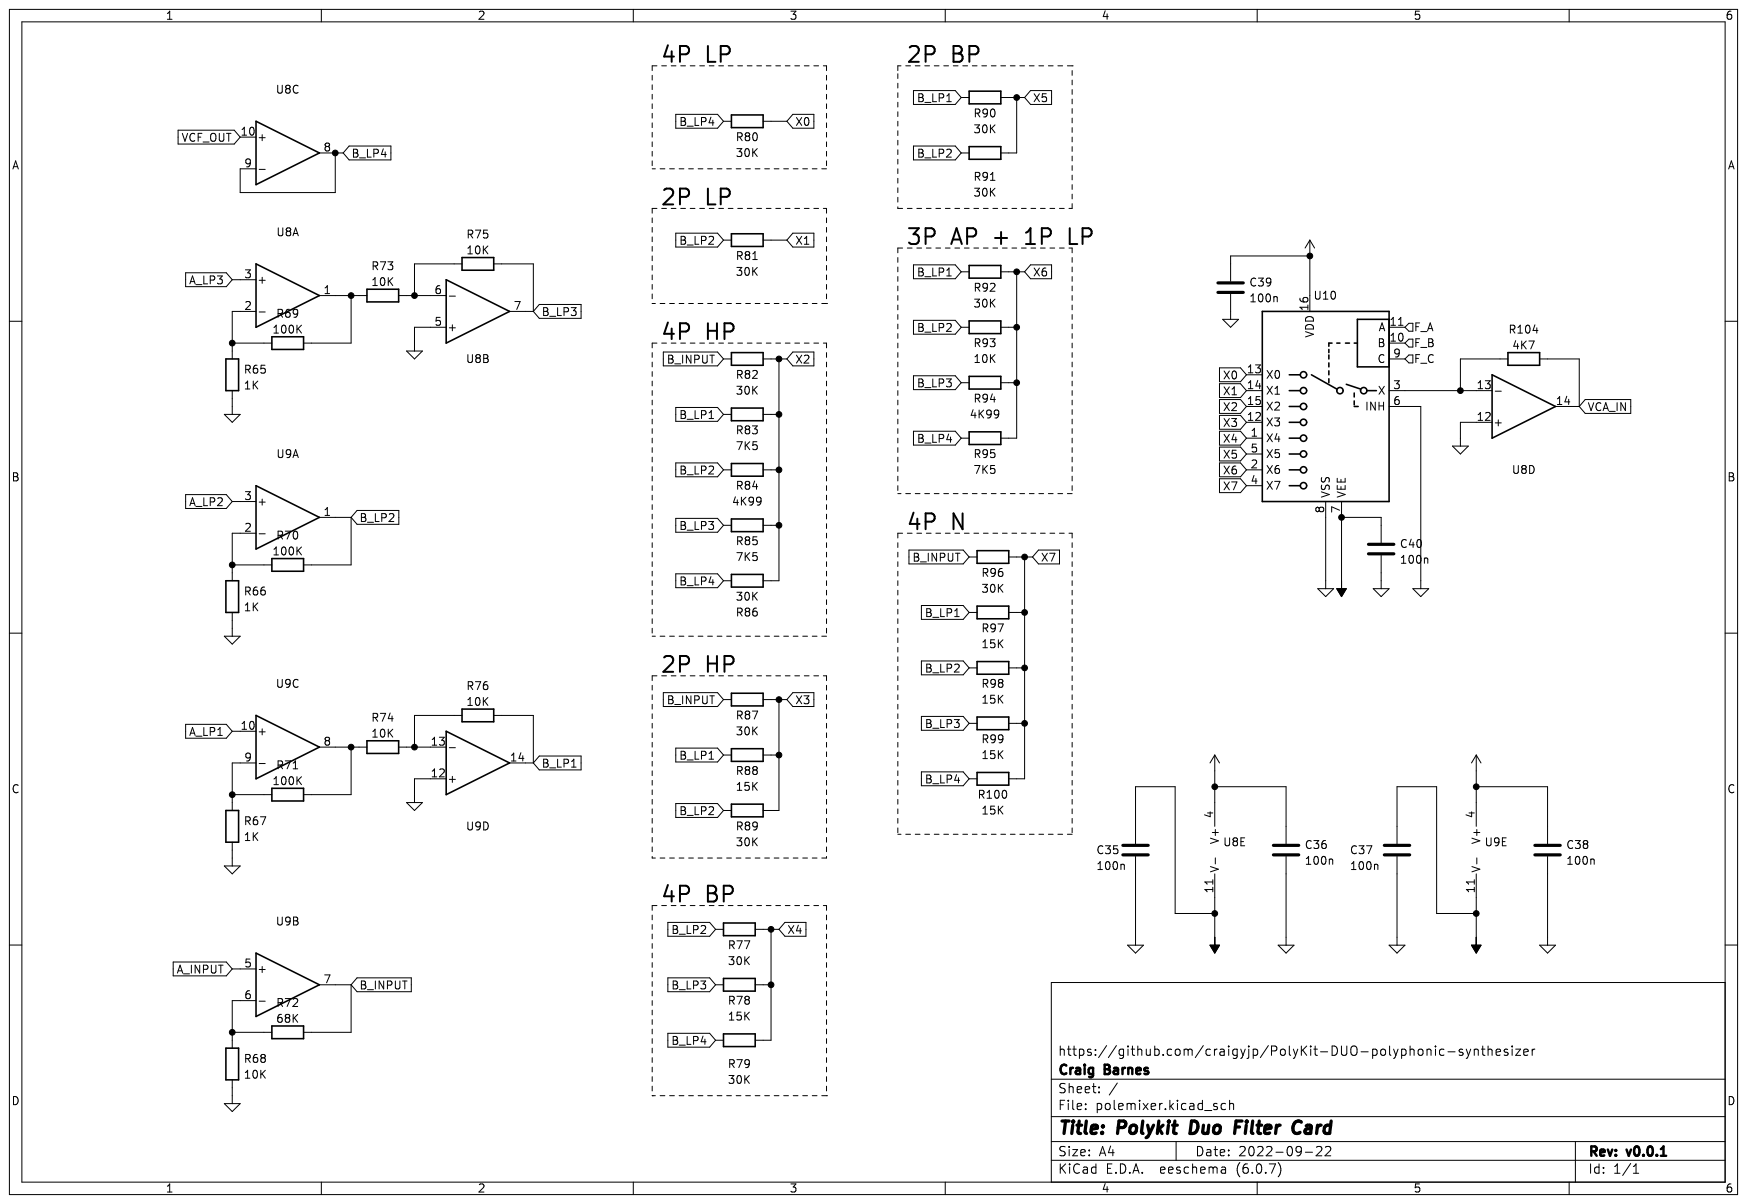
[picture p45: page 1]
