craigyjp/PolyKit-DUO-polyphonic-synthesizer/schematics/LFO_VCA.pdf

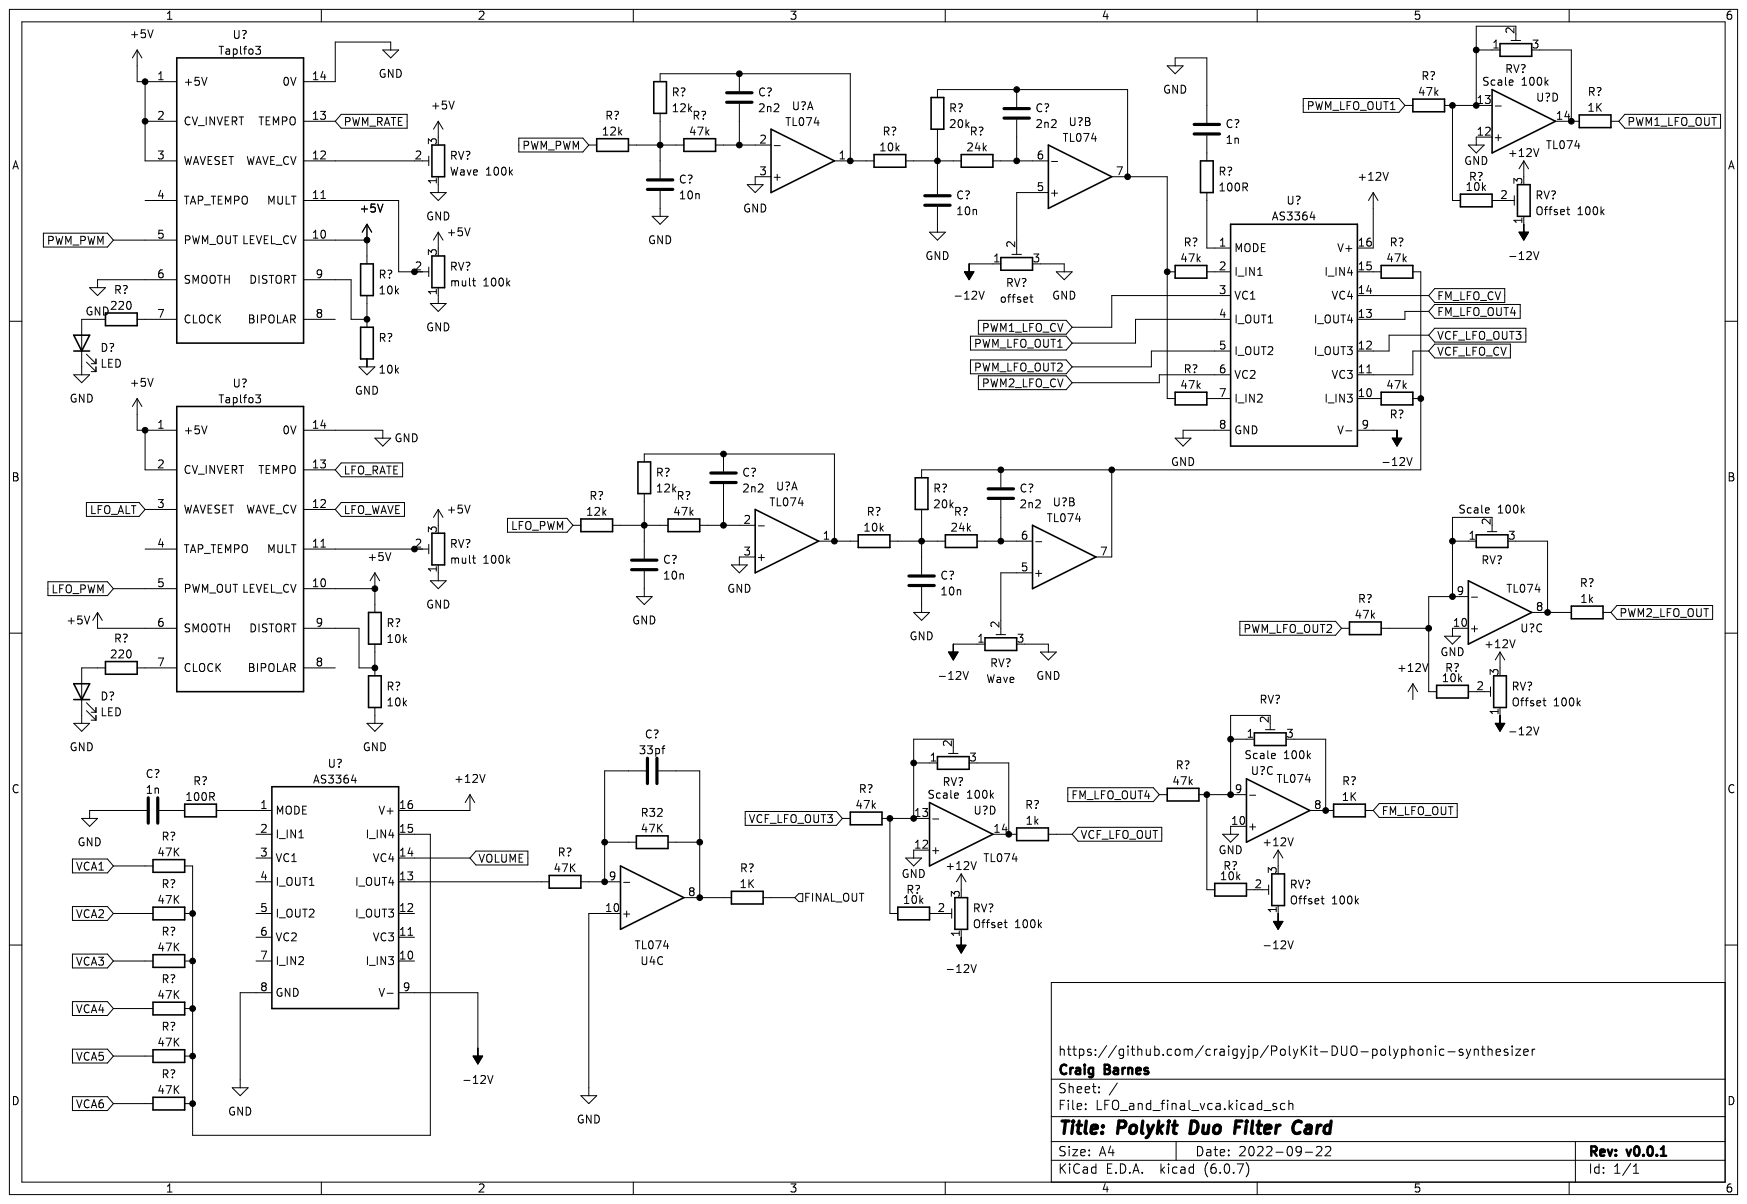
[picture p46: page 1]
