craigyjp/PolyKit-DUO-polyphonic-synthesizer/src/Constants.h

const char* VERSION = "V1.4";
const float FILTERCUTOFF[128] = {20, 23, 26, 29, 32, 36, 40, 46, 53, 60, 69, 78, 87, 98, 109, 120, 132, 145, 157, 171, 186, 200, 215, 231, 247, 264, 282, 300, 319, 338, 357, 378, 399, 421, 444, 467, 491, 516, 541, 567, 594, 621, 650, 680, 710, 741, 774, 806, 841, 876, 912, 949, 987, 1027, 1068, 1110, 1152, 1196, 1242, 1290, 1338, 1388, 1439, 1491, 1547, 1603, 1661, 1723, 1783, 1843, 1915, 1975, 2047, 2119, 2191, 2263, 2347, 2419, 2503, 2587, 2683, 2767, 2863, 2959, 3055, 3163, 3259, 3367, 3487, 3595, 3715, 3835, 3967, 4099, 4231, 4363, 4507, 4663, 4807, 4963, 5131, 5287, 5467, 5635, 5815, 6007, 6199, 6403, 6607, 6823, 7039, 7267, 7495, 7735, 7987, 8239, 8503, 8779, 9055, 9343, 9643, 9955, 10267, 10603, 10939, 11287, 11647, 12000};
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
const float PULSEWIDTH[128] = {0, 0, 0, 1, 1, 2, 2, 3, 3, 3, 4, 4, 4, 5, 5, 6, 6, 6, 7, 7, 8, 8, 8, 9, 9, 10, 10, 10, 11, 11, 12, 12, 12, 13, 13, 14, 14, 14, 15, 15, 15, 16, 16, 17, 17, 17, 18, 18, 19, 19, 20, 20, 20, 21, 21, 22, 22, 22, 23, 23, 23, 24, 24, 24, 25, 25, 25, 26, 26, 26, 27, 27, 27, 28, 29, 29, 29, 30, 30, 31, 31, 31, 32, 32, 33, 33, 34, 34, 35, 35, 36, 36, 37, 37, 37, 38, 38, 39, 39, 40, 40, 40, 41, 41, 41, 42, 42, 43, 43, 44, 44, 44, 45, 45, 45, 46, 46, 47, 47, 47, 48, 48, 49, 49, 49, 50, 50, 50};
#define PITCHLFOOCTAVERANGE 2.0f//2 Oct range
#define RE_READ -9
#define LFOMAXRATE 40.0f//40Hz
#define ONE 1.0f
#define GLIDEFACTOR 5000.0f//Maximum glide time
#define NO_OF_VOICES 6
#define NO_OF_PARAMS 68
const char* INITPATCHNAME = "Initial Patch";
#define HOLD_DURATION 1000
#define PATCHES_LIMIT 999
const String INITPATCH = "Solina,1,1,1,1,1,1,1,1,1,10,1,1,1,1,1,1,1,1,1,10,1,1,1,1,1,1,1,1,1,10,1,1,1,1,1,1,1,1,1,10,1,1,1,1,1,1,1";
