craigyjp/PolyKit-DUO-polyphonic-synthesizer/src/EepromMgr.h

#include <EEPROM.h>

#define EEPROM_MIDI_CH 0
#define EEPROM_AFTERTOUCH 1
//#define EEPROM_PITCHBEND 2
#define EEPROM_MODWHEEL_DEPTH 3
#define EEPROM_ENCODER_DIR 2
#define EEPROM_LAST_PATCH 5
#define EEPROM_FILTERENV 6
#define EEPROM_AMPENV 7

int getMIDIChannel() {
  byte midiChannel = EEPROM.read(EEPROM_MIDI_CH);
  if (midiChannel < 0 || midiChannel > 16) midiChannel = MIDI_CHANNEL_OMNI;//If EEPROM has no MIDI channel stored
  return midiChannel;
}

void storeMidiChannel(byte channel)
{
  EEPROM.update(EEPROM_MIDI_CH, channel);
}

float getAfterTouch() {
 byte AfterTouchDest = EEPROM.read(EEPROM_AFTERTOUCH);
 if (AfterTouchDest == 0) return 0;
 if (AfterTouchDest == 1) return 1;
 return AfterTouchDest; //If EEPROM has no key tracking stored
}


void storeAfterTouch(byte AfterTouchDest)
{
 EEPROM.update(EEPROM_AFTERTOUCH, AfterTouchDest);
}

//int getPitchBendRange() {
//  byte pitchbend = EEPROM.read(EEPROM_PITCHBEND);
//  if (pitchbend < 1 || pitchbend > 12) return pitchBendRange; //If EEPROM has no pitchbend stored
//  return pitchbend;
//}
//
//void storePitchBendRange(byte pitchbend)
//{
//  EEPROM.update(EEPROM_PITCHBEND, pitchbend);
//}

float getModWheelDepth() {
  int mw = EEPROM.read(EEPROM_MODWHEEL_DEPTH);
  if (mw < 1 || mw > 10) return modWheelDepth; //If EEPROM has no mod wheel depth stored
  return mw;
}

void storeModWheelDepth(float mwDepth)
{
  int mw =  mwDepth;
  EEPROM.update(EEPROM_MODWHEEL_DEPTH, mw);
}

boolean getEncoderDir() {
  byte ed = EEPROM.read(EEPROM_ENCODER_DIR); 
  if (ed < 0 || ed > 1)return true; //If EEPROM has no encoder direction stored
  return ed == 1 ? true : false;
}

void storeEncoderDir(byte encoderDir)
{
  EEPROM.update(EEPROM_ENCODER_DIR, encoderDir);
}

boolean getFilterEnv() {
  byte fenv = EEPROM.read(EEPROM_FILTERENV); 
  if (fenv < 0 || fenv > 1)return true;
  return fenv == 0 ? false : true;
}

void storeFilterEnv(byte filterLogLin)
{
  EEPROM.update(EEPROM_FILTERENV, filterLogLin);
  //updateFilterEnv();
}

boolean getAmpEnv() {
  byte aenv = EEPROM.read(EEPROM_AMPENV); 
  if (aenv < 0 || aenv > 1)return true;
  return aenv == 0 ? false : true;
}

void storeAmpEnv(byte ampLogLin)
{
  EEPROM.update(EEPROM_AMPENV, ampLogLin);
  //updateAmpEnv();
}

int getLastPatch() {
  int lastPatchNumber = EEPROM.read(EEPROM_LAST_PATCH);
  if (lastPatchNumber < 1 || lastPatchNumber > 999) lastPatchNumber = 1;
  return lastPatchNumber;
}

void storeLastPatch(int lastPatchNumber)
{
  EEPROM.update(EEPROM_LAST_PATCH, lastPatchNumber);
}
