craigyjp/PolyKit-DUO-polyphonic-synthesizer/src/MidiCC.h

//MIDI CC control numbers
//These broadly follow standard CC assignments
#define   CCmodwheel  1 //pitch LFO amount - less from mod wheel
#define   CCLfoDepth  3 //pitch LFO amount - panel control
#define   CCglideTime 5
#define   CCvolumeControl  7

#define   CCstack 12
#define   CCchorus1 13
#define   CCchorus2 14
#define   CCfmDepth 15
#define   CCosc1PW 16
#define   CCosc2PW  17
#define   CCosc1PWM  18
#define   CCosc2PWM 19

#define   CCvcaGate 21
#define   CCfilterLFO 22
#define   CCnoiseLevel  23
#define   CCfilterPoleSW 24//Off/On
#define   CCkeytrack  30//Off/On
#define   CCmonoMulti 37
#define   CCfilterType 39
#define   CCvcaLoop 41
#define   CCvcaVel 42
#define   CCfilterVel 43
#define   CCfilterRelease  44
#define   CCfilterAttack 45
#define   CCfilterSustain  46
#define   CCfilterDecay  47
#define   CCfilterLevel  48
#define   CCfilterEGinv  50
#define   CCfilterLoop  52
#define   CCfilterEGlevel  53
#define   CCosc1Range  54
#define   CCosc2Range  55
#define   CCampRelease  57
#define   CCampAttack 58
#define   CCampSustain  59
#define   CCampDecay  60
#define   CCglideSW 65
#define   CCPitchBend 66
#define   CCAmpvelo  68
#define   CCosc2Detune 71
#define   CCfilterCutoff  74
#define   CClfoAlt  76
#define   CCLFORate 77
#define   CCosc1PulseLevel 80
#define   CCosc1SawLevel  81
#define   CCpwLFO  90
#define   CCLFOWaveform  91
#define   CCfilterRes  94
#define   CCosc2PulseLevel  102
#define   CCosc2SawLevel  103
#define   CCallnotesoff 123//Panic button
