craigyjp/PolyKit-DUO-polyphonic-synthesizer/(commit log)

2022-09-23 Add files via upload
    converted to kicad
2022-09-24 Add files via upload
    Fixed resonance too sensitive to self oscillation
    [PolyKitDCO.ino]
2022-09-24 Add files via upload
    Fixed modwheel depth
    [PolyKitDCO.ino]
2022-09-25 Add files via upload
    Fixed DAC ground wire to correct pin and capacitor for Vref. Added pins for interconnect.
2022-10-13 Added extra buffer for gates
    The gate signal was falling to 2.2v from 5V so I added an extra 4504 buffer to drive the LEDs seperately from the GATE signals
2022-10-13 Fixed portamento, filter and LFO names
    [EepromMgr.h, Parameters.h, PolyKitDCO.ino, ST7735Display.h, Settings.h]
2023-03-29 Fixed midi channel note handling
    [Constants.h, PolyKitDCO.ino, ST7735Display.h]
2023-03-30 Added DCO analogue section with PWM changes
2023-03-30 Removed unnecessary DAC for PW1 & 2
    I moved the PW1 and 2 to the Sample and hold as the DAC was surplus to requirements.
